BenGu0530/pengu/pengu_mujoco/docs/grid5/figs/leg_extension_vs_crank.png

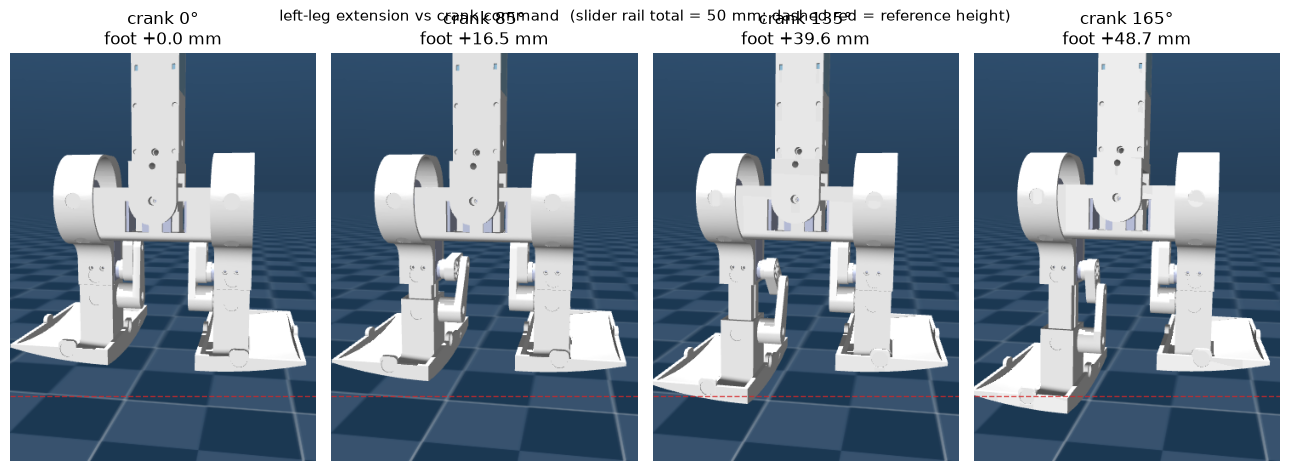
pengu_mujoco/docs/grid5/figs/leg_extension_vs_crank.png
