BenGu0530/pengu/pengu_mujoco/rl_grid4/overnight/retro_c/report.txt

=== retro_c ===
cand              vtail  vswg  fall  eplen   roll  rollμ  |μ|/R  rate   hipc   asym  sing  ePass  eNfwd
-------------------------------------------------------------------------------------------------------
no_back           0.103 0.097  0.56    349   34.3  -30.4   0.89    48   0.26  0.138  0.56   0.90  0.321   HELD-LEAN,unstable
no_fall           0.220 0.018  1.00     70   67.3   19.1   0.28    15  -0.84 -0.138  0.89   0.00  0.005   STATIC-TORSO,FAKE-TORSO

reward budget at the last diag row (per step):
cand                 track  progress      back    energy     swing     scrub    smooth        hf      fall  pos_sum     net
no_back              0.223     0.240     0.000    -0.008     0.114    -0.165    -0.011    -0.163    -0.040    0.578   0.191
no_fall              0.390     0.252    -0.051    -0.003     0.103    -0.161    -0.006    -0.072     0.000    0.745   0.453

HELD-LEAN     |roll_mean|/roll_RMS > 0.7 -- torso parked to one side, not swinging.
              This is the failure that reads as a success in the summary numbers.
STATIC-TORSO  high roll RMS but roll RATE < 30 deg/s -- leaning, barely moving.
FAKE-TORSO    high roll RMS in eval but net_fwd < 0.03 -- the exact false positive
              Ben flagged: reads as strong torso use, goes nowhere.
ASYM          |stride_asym| > 0.25 -- one leg taking much longer strides, i.e.
              curving or compensating for a held lean.
unstable      vswing > 0.05 over the last 1M steps; the vtail is a draw, not a value.
Frames: overnight/<gen>/frames/<cand>_strip.png  (t = 3, 6, 9 s stacked)
