BenGu0530/pengu/pengu_mujoco/docs/sim_reference_c6_mu01_mu05.md

# Simulation reference — pengu c6, mu = 0.1 and mu = 0.5

MuJoCo, config **c6** (torso follow gain kappa = 2, COM ratio 1.31, mass 2.2724 kg).
Generated by `pengu_mujoco/hardware/sim_stepwise.py` and `grid5/walk_prediction.py`.

## Gaits

| | freq (Hz) | hip_phi (deg) | leg_amp (deg) | hip_amp (deg) | hip_off (deg) |
|---|---|---|---|---|---|
| mu = 0.1 champion | 1.67 | 340 | 95 | 24 | 20 |
| mu = 0.5 champion | 1.92 | 240 | 115 | 20 | 10 |

`leg_amp` is also given at the amplitude the hardware servos actually deliver (0.865 of
command, velocity-limited near 430 deg/s), so 95 -> 82 and 115 -> 99.

## Velocity — per-footfall method

Body position sampled at every footfall, consecutive samples differenced. Turning counts;
within-stride oscillation cancels because every touchdown is the same gait phase.
Footfalls detected from foot-body height. `v_pooled` = total distance / total time;
`v_mean` = mean of per-step velocities; `v_net` = ||end - start|| / time for comparison.

| config | steps | v_pooled | v_mean | v_median | v_sd | v_net | step len (m) | step period (s) | distance (m) | time (s) |
|---|---|---|---|---|---|---|---|---|---|---|
| mu=0.1, leg 95 | 78 | **0.512** | 0.496 | 0.496 | 0.043 | 0.509 | 0.1419 | 0.264 | 7.98 | 15.6 |
| mu=0.1, leg 82 | 103 | **0.378** | 0.355 | 0.367 | 0.038 | 0.374 | 0.0974 | 0.264 | 5.89 | 15.6 |
| mu=0.5, leg 115 | 61 | **0.158** | 0.156 | 0.155 | 0.046 | 0.141 | 0.0395 | 0.264 | 2.51 | 15.9 |
| mu=0.5, leg 99 | 62 | **0.157** | 0.152 | 0.130 | 0.083 | 0.133 | 0.0352 | 0.258 | 2.49 | 15.9 |

All velocities in m/s. Window: 16 s, starting 6 s after the staged start settles.

## Attitude and actuator load

A = hip-axis (lower body) roll, T = torso roll, both as tilt about the torso hinge axis;
J = torso joint angle, T = A + J. The controller targets T = kappa * A, so T/A is its
objective. Torques are p95 over the window; stall is 4.1 N.m.

| | A rms (deg) | T rms (deg) | T/A | J/A | J amp (deg) | torso cmd amp (deg) |
|---|---|---|---|---|---|---|
| mu=0.1, leg 95 | 11.40 | 23.30 | 2.02 | 1.06 | 38.1 | 44.2 |
| mu=0.5, leg 115 | 1.60 | 3.30 | 2.06 | — | 7.1 | 9.6 |

| | torso p95 | hip p95 | crank p95 | torso >=90% stall |
|---|---|---|---|---|
| mu=0.1, leg 95 | 4.10 | 2.40 | 1.11 | 13.2% |
| mu=0.5, leg 115 | 1.19 | 1.56 | 1.79 | 0% |

Torque in N.m. The mu=0.1 champion holds the torso at the stall limit for 13% of the
window; the mu=0.5 gait never approaches it.

## Friction sweep — mu = 0.1 champion gait, mu varied

| mu | 0.08 | 0.10 | 0.11 | 0.12 | 0.135 | 0.15 | 0.16 | 0.175 | 0.20 |
|---|---|---|---|---|---|---|---|---|---|
| step len, leg 95 | 0.124 | 0.142 | 0.126 | 0.123 | 0.127 | 0.110 | 0.081 | 0.097 | **0.021** |
| v_pooled, leg 95 | 0.462 | 0.512 | 0.479 | 0.475 | 0.479 | 0.405 | 0.353 | 0.375 | **0.078** |
| step len, leg 82 | 0.099 | 0.097 | 0.098 | 0.096 | 0.097 | 0.094 | 0.095 | 0.089 | **0.016** |
| v_pooled, leg 82 | 0.415 | 0.378 | 0.372 | 0.357 | 0.345 | 0.351 | 0.351 | 0.327 | **0.060** |

Step length is flat from mu = 0.08 to 0.175 and collapses at 0.20.

## Contact and actuator model as configured

```
option        timestep 0.001   integrator implicitfast
              friction cone PYRAMIDAL (default)   impratio 1 (default)
floor         type plane   condim 3 (default)   geom_priority raised above the feet
              friction[0] set per surface; solref/solimp at defaults
foot geoms    friction 0.9 0.005 0.0001
joints        frictionloss 0.1   armature 0.005
actuators     position servo, kp 50, dampratio 1, forcerange +-4.1 N.m
              torso ctrlrange +-0.7854 rad;  NO velocity limit on any actuator
torso PID     kappa 2, kp 2.0, ki 0.1, kd 0, clamp +-45 deg, stepped at 1 kHz
```

Only `friction[0]` (sliding) is changed per surface. **Torsional friction stays at 0.005
and rolling at 0.0001 for every mu**, i.e. the ice and the lab floor are given identical
resistance to a foot pivoting.
