BenGu0530/pengu/pengu_mujoco/docs/grid4_fleet_memo.md

# GRID-4 fleet memo — who runs what

> **STAGED-K AMENDMENT (Ben, 2026-08-16).** The map is now swept at **K=1**
> (`DR_K=1`: one jittered trial per (cell,μ) = trial r=0 of the seeded sequence).
> Hot regions get topped up to K=5 afterwards with `physics/topup_k.py`, which runs
> r=1..4 and merges — validated bit-identical to a native K=5 sweep on the smoke grid.
> Everything else (grid, μ levels, jitters, pass rule, schema, filenames) unchanged.
> **Switch procedure on B, C and D** (Mac already switched 2026-08-16; D launched c4
> at K=5 before this amendment, so it switches too):
> ```bash
> cd ~/pengu/pengu_mujoco && git pull              # D: cd $HOME/Documents/ben_gu/ben_pengu/pengu/pengu_mujoco
> pkill -f 'grid4_sweep[.]py'                      # D: use the argv-exact kill from its memo instead
> CSV=results/gait_sweep/sweep_grid4_cN_freq_hip_phi_leg_amp_hip_amp_hip_off_mu.csv
> mv "$CSV" "$CSV.k5partial"                       # archive; NEVER mix K values in one CSV
> head -1 "$CSV.k5partial"                         # sanity: header line present
> # WSL (B/C): re-arm the anchor if the distro restarted. Then relaunch:
> DR_K=1 GRID3_PY=$HOME/pengu/pengu_mujoco/.sweep_venv/bin/python bash physics/run_sweep.sh cN
> # D (shared box): DR_K=1 GRID3_PY=$REPO/.sweep_venv/bin/python nice -n 19 bash physics/run_sweep.sh c4
> tail -2 results/gait_sweep/cN_run.log            # startup line must say K=1
> ```
> K=1 ETA: Mac ~3.4 d, B ~12 d, C ~3.8 d, D ~3 d per config.

Full spec: `docs/grid4_guide.md`. Protocol is FROZEN (commit `a22f80b`): base = hardened
`models/pengu1_31` (2.2724 kg), COM rungs {1.05, 1.20, 1.31} built in-memory at load,
μ axis {0.1, 0.3, 0.5, 0.7} ±5% rel., K=5, pose jitter, no mass jitter,
pass = survive ∧ heading>0.5 ∧ net_fwd>0.05 (slip recorded, not gated).
Do NOT change any parameter mid-fleet — one changed value = a different sweep.

## Assignment (one machine = one config = one CSV; no cross-machine merging)

| machine | now | after that |
|---|---|---|
| **Mac** (Ben's) | c1 handed off at 1,524,017 rows (2026-08-19) | idle |
| **B** (Ryzen/WSL2, `grid4_machineB_memo.md`) | **c2** — STOP after snapshot push (`grid4_c2_takeover_memo.md`) | done |
| **C** (XPS/WSL2, `grid4_xps_memo.md`) | **c3** — ✅ COMPLETE 2026-08-19 | idle / backup analysis box |
| **D** (Linux, `grid4_machineD_memo.md`) | **c1** takeover from Mac snapshot: `SWEEP_NICE=19 bash physics/resume_config.sh c1` | topup |
| **E** (friend's 32-core desktop) | **c5** ✅ | idle / topup |
| **F** (`rml3` Linux desktop, repo at `~/Documents/ben/pengu`) | **c6** ✅, analysis ✅ → **continues c2**: `bash physics/resume_c2.sh` (one-shot, self-contained) | rerun analysis when c1/c2 land |

With E/F online every config has a dedicated machine. `run_sweep.sh` now defaults GRID-4
jobs to `DR_K=1` (staged-K), so the plain one-liner is correct on a fresh clone.

When a machine frees up and c2 is still far from done, it joins c2 with a DISJOINT
shard split (e.g. B keeps `N_SHARDS=11 SHARD_ID 0..10` as-is; helper runs
`N_SHARDS=33 SHARD_ID 11..32`-style non-overlapping params into its own copy, then
concat + dedupe on the 6 axis cols). Coordinate in this file before starting.

Each config = 1,818,000 rows (+1 header). Measured rates: Mac ~4.3k rows/h,
B ~1.24k, C ~3.96k, D ~5.0k — ETA ~17/60/19/15 days respectively; resume is automatic,
restarts are safe.

## New machine setup (Linux / Mac; Windows → use WSL2; Linux VM fine)

```bash
git clone https://github.com/robomechanics/pengu.git && cd pengu/pengu_mujoco
git checkout friction-experiments
bash physics/run_sweep.sh c2          # machine C: c3   (2nd arg = shard count, default cores-2)
```

No mujoco python found → the launcher builds `.sweep_venv` and pip-installs
mujoco/numpy/cma automatically.

- Windows: install WSL2 (`wsl --install`), work inside `~/` (NOT `/mnt/c` — slow I/O),
  set Windows power to never sleep. **Native Windows does NOT work** (mujoco 3.8.x DLL
  fails to load — measured on machine C; WSL2 is mandatory).
- **WSL2 keepalive is REQUIRED**: with no terminal attached the distro shuts down within
  ~45 s and kills every shard (measured on machine B). Arm an anchor from Windows before
  walking away, and re-arm after every reboot/logoff:
  ```
  powershell -c "Start-Process wsl.exe -ArgumentList '-d','Ubuntu','-e','sleep','infinity' -WindowStyle Hidden"
  ```
- VM: give it all cores, local virtual disk (no shared folders), host must not sleep.
- Mac: `caffeinate -dimsu &` to prevent sleep. Linux: disable suspend.

## Pre-flight (2 min, before leaving a machine unattended)

1. `git rev-parse --short HEAD` matches the other machines.
2. `CONFIG=cN python physics/grid4_sweep.py count` prints
   `cells=454500 mus=[0.1, 0.3, 0.5, 0.7] rows=1818000 K=5` (and the right config/kappa/com).
   (numpy ≥2.3 prints `np.float64(0.1)` — cosmetic, values identical.)
3. After launch: `wc -l` on the CSV grows; startup line in
   `results/gait_sweep/cN_run.log` shows `com=<target> ... mass=2.2724kg`.
   To verify COM/mass without waiting for the (buffered) log, run a zero-row probe
   — **AFTER the launcher, never before it** (see step 4):
   ```bash
   CONFIG=cN N_SHARDS=999999 SHARD_ID=999998 .sweep_venv/bin/python -u physics/grid4_sweep.py
   ```
   Expected slides: 1.05→−86.05 mm, 1.20→−31.37 mm, 1.31→+8.73 mm, always `mass=2.2724kg`.
4. **Header check — do this on every machine, and before every relaunch** (machine-D
   finding, 2026-08-16):
   ```bash
   CSV=results/gait_sweep/sweep_grid4_cN_freq_hip_phi_leg_amp_hip_amp_hip_off_mu.csv
   head -1 "$CSV"          # MUST be: freq,hip_phi,leg_amp,hip_amp,hip_off,mu,...
   ```
   If line 1 is a data row, the CSV has **no header** and resume is dead: `_load_done`
   reads via `csv.DictReader`, treats row 1 as the field names, and recovers 0 rows — so
   every restart re-runs from scratch and appends duplicates. Cause: the zero-row probe
   opens the CSV with `"a"` and creates a 0-byte file, after which `initcsv`'s
   `if not os.path.exists(...)` guard skips the header. The launcher also tells you:
   `launched cN: … resuming from -1 done rows` means the file exists but is empty/headerless.
   Repair (**only while no shard is running** — shards hold the fd in append mode, so
   swapping the inode under them loses rows):
   ```bash
   # stop shards first, then:
   printf 'freq,hip_phi,leg_amp,hip_amp,hip_off,mu,pass_rate,surv_rate,net_fwd_mean,net_fwd_min,slip_mean,head_mean\r\n' > "$CSV.new"
   cat "$CSV" >> "$CSV.new" && mv "$CSV.new" "$CSV"     # CRLF: DictWriter's terminator
   ```
   Then relaunch and confirm the log says `resuming from <N> done rows` with N = data rows.
   Existing data rows are unaffected — this only restores resume.

Gotcha: pass `GRID3_PY` as an ABSOLUTE path (e.g. `$HOME/...`), not `$PWD/...` — it
expands before the script's `cd` (machine-C finding).

## Watching

```bash
wc -l results/gait_sweep/sweep_grid4_cN_freq_hip_phi_leg_amp_hip_amp_hip_off_mu.csv
tail -f results/gait_sweep/cN_run.log
```

## Ship-back when a config completes (1,818,000 rows)

```bash
CSV=results/gait_sweep/sweep_grid4_cN_freq_hip_phi_leg_amp_hip_amp_hip_off_mu.csv
awk 'NF' "$CSV" > t && mv t "$CSV"                     # strip stray blank lines
# integrity: rows=1,818,001 incl header; all NF==12; unique 6-tuples = 1,818,000
gzip -kf "$CSV" && git add -f "$CSV.gz"
git commit -m "GRID-4 cN complete" && git push
```
Then start the machine's batch-2 config (`run_sweep.sh c4/c5/c6`).
No AI attribution in commit messages. Branch: `friction-experiments`.

## Per-machine routine (compiled from the machine memos)

**B (WSL2, c2)** — details `grid4_machineB_memo.md`:
1. After every Windows reboot/logoff: re-arm the WSL anchor (command above), THEN
   relaunch: `GRID3_PY=$HOME/pengu/pengu_mujoco/.sweep_venv/bin/python bash physics/run_sweep.sh c2`.
2. Check-in: `pgrep -fc grid4_sweep.py` = 11; `wc -l` on the c2 CSV grows.
3. Ship-back at 1,818,000 rows per the block below.

**C (WSL2, c3)** — details `grid4_xps_memo.md`:
1. Same anchor + relaunch rule as B (`... run_sweep.sh c3`; expect 14 shards).
2. Check-in additionally watches for the shard-death incident: if `pgrep -fc` < 14,
   relaunch (safe), and note it in the memo — twice means it needs diagnosis.
3. Keep on AC; Modern-Standby power settings already applied (see memo).
4. After c3 ships: start c6.

**D (Linux, c4)** — details `grid4_machineD_memo.md`: no WSL anchor needed; disable
suspend once; daily `pgrep`/`wc -l`; after c4 ships, help c2 per the split above.
Two D-specific rules: the clone is at `~/Documents/ben_gu/ben_pengu/pengu/pengu_mujoco`,
not `~/pengu`; and the box is SHARED with Isaac Lab GPU training, so always launch under
`nice -n 19` (see the memo) — 14 shards at nice 0 starve the trainer's CPU-side stepping.

**Mac (c1)** — Claude-managed on Ben's machine (caffeinate + completion monitor armed);
after c1 ships: c5.

## Open items (Ben)

- pitch (torso forward-lean) axis: definition + full-cross vs staged — decides whether
  more configs are queued after batch 2. Does not block batches 1–2.
- RL (6 policies) and the mass-effect control: deferred until the table is in.

## RL-phase fleet rules (Ben, 2026-08-22 — after the C8 near-loss)

1. runs/ layout changes must be announced in a memo BEFORE pushing; other
   machines finish + commit (git add -f) local run outputs before pulling.
2. Every training run tees stdout to a .log committed alongside diag.csv.

## ANNOUNCEMENT 2026-08-22 (Mac): REWARD default changed r2 -> r3

`grid4_rl_env.py` RW_DEFAULT now includes `hf: 0.5` (high-frequency action
penalty, see rl_e2_ice_memo knob log). Any training launched AFTER pulling
this is r3 by default and tags itself r3. Consequences for in-flight work:

- overnight gen* arms: gen01/gen02 ran under r2. Post-pull generations will
  be r3 — do NOT pool them with r2 generations; the tag separates them.
- To launch an exact-r2 run under new code: `--rw hf=0.0` (retags with rw
  override, keeping pools separate).
- Eval/render/ckpt tools are unaffected (reward not used at eval).
- Mac is running the r3 2x2 rerun at rl_grid4/runs/e2x2hf/ (4 cells x 3M,
  ~5 h from 10:48 EDT); please avoid launching heavy jobs on Mac until done.

## Coordination note 2026-08-22 (Mac -> machine D)

Your e2_base (run_base_seeds.sh: --mode e2 --curriculum, default reward,
seeds 0/1/2) is the SAME recipe as Mac's runs/e2x2hf4b/a1p1 (REWARD r3d,
hf=0.6 hips+torso commanded residual) — seed 0 would be a byte-duplicate;
Mac's copy is trained+evaled (stand, 0/5 all mu). Seeds 1/2 are new and
useful. When pooling, treat e2x2hf4b/a1p1 as e2_base s0. Also: default
REWARD_VERSION moved r3 -> r3b -> r3c -> r3d within 2026-08-22 (see
rl_e2_ice_memo knob log + grid4_rl_env.py header); verify the version tag in
your run dirs matches r3d before pooling generations.

## ANNOUNCEMENT 2026-08-23 (Mac): EXECUTION layer sv0 -> sv1 (servo slew clamp)

grid4_rl_env now clamps applied position targets at 4.82 rad/s (XM430-W350
no-load @ 12 V; models Profile Velocity). Default ON for train/eval/render/
score/ckpt-sweep; `--no-slew` reproduces legacy sv0 exactly. New train runs
tag themselves `sv1`. Do NOT pool sv0 and sv1 runs. Designed baselines are
being re-scored under sv1 (see rl_session memo); legacy numbers stay archived
as sv0. If a generation is mid-flight when you pull this, finish it as sv0
(its processes hold the old code) and launch the next one under sv1.
