BenGu0530/pengu/Arduino/pengu/pengu.rtf

// EasyPengu.ino
#include <DynamixelShield.h>

#include <Wire.h>

#include <Adafruit_Sensor.h>

#include <Adafruit_BNO055.h>

#include <utility/imumaths.h>

#include <WiFiNINA.h>

using namespace ControlTableItem;

#define DEBUG_SERIAL Serial

// ===================== Motor IDs =====================
const uint8_t XM_LEFT_SLIDE = 4;
const uint8_t XM_RIGHT_SLIDE = 3;
const uint8_t XM_LEFT_HIP = 2;
const uint8_t XM_RIGHT_HIP = 1;
const uint8_t XM_TORSO_ROLL = 0;

const uint8_t MOTOR_IDS[] = {XM_LEFT_SLIDE, XM_RIGHT_SLIDE, XM_LEFT_HIP, XM_RIGHT_HIP, XM_TORSO_ROLL};
const int MOTOR_COUNT = 5;

DynamixelShield dxl;
Adafruit_BNO055 bno = Adafruit_BNO055(55, 0x28);

// ===================== State machine =====================
enum RobotState { STATE_IDLE, STATE_READY, STATE_WALK };
RobotState robot_state = STATE_IDLE;

// ===================== IMU globals (read by wireless.ino) =====================
float imu_yaw = 0, imu_roll = 0, imu_pitch = 0;
float imu_ax = 0, imu_ay = 0, imu_az = 0;
uint8_t cal_sys = 0, cal_gyro = 0, cal_accel = 0, cal_mag = 0;

// ===================== WiFi flag (set by wireless.ino) =====================
bool wifi_active = false;

// ===================== Motion params (also in param_storage.ino) =====================
float p_legAmp = 2.0f; // rad
float p_legFreq = 1.39f; // Hz
float p_hipAmp = 0.2f; // rad

// ===================== Homing =====================
float home_deg[MOTOR_COUNT];
unsigned long walk_start_ms = 0;

const float lean_angle_ticks = 30.0f;
const float torso_zero_deg = 154.0f;
float torso_amp_deg = 0.0f;

// Helper: index of motor ID in MOTOR_IDS[]
int idxOf(uint8_t id) {
for (int i = 0; i < MOTOR_COUNT; i++)
if (MOTOR_IDS[i] == id) return i;
return -1;
}

// ===================== Setup =====================
void setup() {
DEBUG_SERIAL.begin(115200);
while (!DEBUG_SERIAL);

// --- Dynamixel ---
dxl.begin(1000000);
dxl.setPortProtocolVersion(2.0);

DEBUG_SERIAL.println("Checking motors...");
bool all_ok = true;
for (int i = 0; i < MOTOR_COUNT; i++) {
uint8_t id = MOTOR_IDS[i];
if (!dxl.ping(id)) {
DEBUG_SERIAL.print("No response from ID: "); DEBUG_SERIAL.println(id);
all_ok = false;
} else {
DEBUG_SERIAL.print("Found ID: "); DEBUG_SERIAL.println(id);
}
}
if (!all_ok) {
DEBUG_SERIAL.println("ERROR: missing motors. Halting.");
while (1);
}

// --- Homing: read current pos, set extended position mode ---
DEBUG_SERIAL.println("Homing...");
for (int i = 0; i < MOTOR_COUNT; i++) {
uint8_t id = MOTOR_IDS[i];
home_deg[i] = dxl.getPresentPosition(id, UNIT_DEGREE);
dxl.torqueOff(id);
dxl.setOperatingMode(id, OP_EXTENDED_POSITION);
dxl.setGoalPosition(id, home_deg[i], UNIT_DEGREE);
dxl.torqueOn(id);
DEBUG_SERIAL.print("ID "); DEBUG_SERIAL.print(id);
DEBUG_SERIAL.print(" home = "); DEBUG_SERIAL.println(home_deg[i], 2);
}

// --- IMU ---
DEBUG_SERIAL.println("Initializing BNO055...");
if (!bno.begin()) {
DEBUG_SERIAL.println("ERROR: BNO055 not detected.");
while (1);
}
bno.setExtCrystalUse(true);
DEBUG_SERIAL.println("BNO055 ready.");

// --- WiFi AP ---
begin_wifi(); // defined in wireless.ino

robot_state = STATE_IDLE;
DEBUG_SERIAL.println("Setup complete. Send 'r' to go Ready, 'w' to Walk.");
}

// ===================== Loop =====================
void loop() {

// --- 1. Read IMU ---
update_imu();

// --- 2. Handle WiFi + get command ---
char cmd = 0;
if (wifi_active) {
cmd = update_wifi(); // defined in wireless.ino
}
// Also accept Serial commands for debugging
if (DEBUG_SERIAL.available()) {
cmd = (char)DEBUG_SERIAL.read();
}

// --- 3. State transitions ---
handle_command(cmd);

// --- 4. Run current state ---
switch (robot_state) {
case STATE_IDLE:
// torque is on but holding home, nothing to do
break;
case STATE_READY:
run_ready();
break;
case STATE_WALK:
run_walk();
break;
}

delay(20); // ~50 Hz loop
}

// ===================== Command handler =====================
void handle_command(char cmd) {
switch (cmd) {
case 'r': // Ready
if (robot_state != STATE_READY) {
DEBUG_SERIAL.println("-> READY");
robot_state = STATE_READY;
}
break;
case 'w': // Walk
if (robot_state == STATE_READY) {
DEBUG_SERIAL.println("-> WALK");
walk_start_ms = millis();
robot_state = STATE_WALK;
} else {
DEBUG_SERIAL.println("Go READY first before WALK.");
}
break;
case 'q': // Stop → back to Ready
if (robot_state == STATE_WALK) {
DEBUG_SERIAL.println("-> READY (stopped)");
robot_state = STATE_READY;
}
break;
}
}

// ===================== READY state =====================
// Hold a defined standing posture: hips neutral, legs pulled in
void run_ready() {
// For now: hold home position for all motors
// TODO: define actual stand angles once hardware is tested
for (int i = 0; i < MOTOR_COUNT; i++) {
dxl.setGoalPosition(MOTOR_IDS[i], home_deg[i], UNIT_DEGREE);
}
}

// ===================== WALK state =====================
void run_walk() {
float t = (millis() - walk_start_ms) / 1000.0f;

float s_leg = sinf(2.0f * PI * p_legFreq * t);
float s_hip = sinf(2.0f * PI * p_legFreq * t);

// --- Leg extension ---
float A_leg = p_legAmp * 180.0f / PI;
float magL = 0.5f * A_leg * (1.0f + s_leg);
float magR = A_leg - magL;
const int SIGN_LEFT = -1;
const int SIGN_RIGHT = +1;
float LlegGoal = home_deg[idxOf(XM_LEFT_SLIDE)] + SIGN_LEFT * magL;
float RlegGoal = home_deg[idxOf(XM_RIGHT_SLIDE)] + SIGN_RIGHT * magR;

// --- Hip pitch ---
float A_hip = p_hipAmp * 180.0f / PI;
float magHL = 0.5f * A_hip * (1.0f + s_hip);
float magHR = A_hip - magHL;
const int SIGN_BACK_LEFT = +1;
const int SIGN_BACK_RIGHT = -1;
float LhipGoal = home_deg[idxOf(XM_LEFT_HIP)] + SIGN_BACK_LEFT * magHL - lean_angle_ticks;
float RhipGoal = home_deg[idxOf(XM_RIGHT_HIP)] + SIGN_BACK_RIGHT * magHR + lean_angle_ticks;

// --- Torso ---
float torsoGoal = home_deg[idxOf(XM_TORSO_ROLL)] + torso_amp_deg * s_leg;

// Send
dxl.setGoalPosition(XM_LEFT_SLIDE, LlegGoal, UNIT_DEGREE);
dxl.setGoalPosition(XM_RIGHT_SLIDE, RlegGoal, UNIT_DEGREE);
dxl.setGoalPosition(XM_LEFT_HIP, LhipGoal, UNIT_DEGREE);
dxl.setGoalPosition(XM_RIGHT_HIP, RhipGoal, UNIT_DEGREE);
dxl.setGoalPosition(XM_TORSO_ROLL, torsoGoal, UNIT_DEGREE);
}

// ===================== IMU update =====================
void update_imu() {
imu::Vector<3> euler = bno.getVector(Adafruit_BNO055::VECTOR_EULER);
imu::Vector<3> accel = bno.getVector(Adafruit_BNO055::VECTOR_LINEARACCEL);
bno.getCalibration(&cal_sys, &cal_gyro, &cal_accel, &cal_mag);

imu_yaw = euler.x();
imu_roll = euler.y();
imu_pitch = euler.z();
imu_ax = accel.x();
imu_ay = accel.y();
imu_az = accel.z();
}
