BenGu0530/pengu/pengu_mujoco/results/grid4_report/REPORT.md

# GRID-4 report

configs included: c1 (κ=0, COM 1.05), c2 (κ=0, COM 1.2), c3 (κ=0, COM 1.31), c4 (κ=2, COM 1.05), c5 (κ=2, COM 1.2), c6 (κ=2, COM 1.31)

## Per-config, per-mu

| config | mu | pass>0 % | mean pass | nbhd>=0.8 | best net_fwd |
|---|---|---|---|---|---|
| c1 | 0.1 | 12.6 | 0.1261 | 35135 | 0.170 |
| c1 | 0.3 | 20.1 | 0.2012 | 63823 | 0.261 |
| c1 | 0.5 | 12.2 | 0.1220 | 24163 | 0.350 |
| c1 | 0.7 | 8.3 | 0.0828 | 11471 | 0.260 |
| c2 | 0.1 | 10.6 | 0.1063 | 26258 | 0.196 |
| c2 | 0.3 | 10.1 | 0.1007 | 17708 | 0.321 |
| c2 | 0.5 | 7.1 | 0.0706 | 10398 | 0.383 |
| c2 | 0.7 | 4.1 | 0.0408 | 4388 | 0.239 |
| c3 | 0.1 | 4.2 | 0.0417 | 2948 | 0.171 |
| c3 | 0.3 | 4.1 | 0.0406 | 1468 | 0.660 |
| c3 | 0.5 | 1.9 | 0.0195 | 252 | 0.274 |
| c3 | 0.7 | 1.1 | 0.0106 | 130 | 0.186 |
| c4 | 0.1 | 31.7 | 0.3169 | 97468 | 0.370 |
| c4 | 0.3 | 31.7 | 0.3173 | 101474 | 0.620 |
| c4 | 0.5 | 12.8 | 0.1275 | 22063 | 0.379 |
| c4 | 0.7 | 9.9 | 0.0992 | 14224 | 0.269 |
| c5 | 0.1 | 23.6 | 0.2360 | 60625 | 0.574 |
| c5 | 0.3 | 10.6 | 0.1055 | 18812 | 0.425 |
| c5 | 0.5 | 2.5 | 0.0247 | 883 | 0.296 |
| c5 | 0.7 | 2.0 | 0.0202 | 602 | 0.250 |
| c6 | 0.1 | 5.6 | 0.0558 | 3697 | 0.602 |
| c6 | 0.3 | 2.1 | 0.0214 | 125 | 0.345 |
| c6 | 0.5 | 0.9 | 0.0086 | 36 | 0.240 |
| c6 | 0.7 | 0.8 | 0.0079 | 47 | 0.209 |

## freq-edge pressure (share of nbhd>=0.8 cells at freq >= 1.9, mu=0.1)

| config | share |
|---|---|
| c1 | 7.9% |
| c2 | 9.2% |
| c3 | 9.0% |
| c4 | 7.1% |
| c5 | 7.8% |
| c6 | 6.3% |

## overlap

see overlap_mu01.png — Jaccard of pass>0 cell sets at mu=0.1.
