BenGu0530/pengu/pengu_mujoco/results/grid5_report/k5/champ_k5_table.md

# Champion K=5 checkup (GRID-4, working notes)

K1 = single-seed map value; K5 = topup_k.py aggregate over the 5 protocol seeds.
M1: floor pass>=0.8, rank K5 mean.  M2: rank net_fwd_min.  M4: M1 AND nbhd>=0.8.

## Champions (map T-speed #1 per config, mu)

| cfg | mu | K1 champ | K5 mean | K5 min | pass | nbhd | K5/K1 | M1 champ | M2 champ | M4 champ |
|---|---|---|---|---|---|---|---|---|---|---|
| c1 | 0.1 | 0.170 | 0.169 | 0.167 | 1.0 | 1.00 | 0.99 | f1.8/φ260 (0.169) | f1.81/φ260 (0.169) | f1.8/φ260 (0.169) |
| c1 | 0.3 | 0.261 | 0.237 | 0.213 | 1.0 | nan | 0.91 | f1.94/φ280 (0.250) | f1.94/φ280 (0.242) | f1.92/φ280 (0.247) |
| c1 | 0.5 | 0.350 | 0.319 | 0.240 | 1.0 | 0.93 | 0.91 | f2/φ0 (0.336) | f1.99/φ0 (0.314) | f1.95/φ0 (0.319) |
| c1 | 0.7 | 0.260 | 0.045 | -0.059 | 0.4 | 0.27 | 0.17 | f1.93/φ250 (0.225) | f1.93/φ250 (0.225) | — |
| c2 | 0.1 | 0.196 | no K5 | | | 0.27 | | | | |
| c2 | 0.3 | 0.321 | no K5 | | | 0.73 | | | | |
| c2 | 0.5 | 0.383 | no K5 | | | nan | | | | |
| c2 | 0.7 | 0.239 | no K5 | | | 0.13 | | | | |
| c3 | 0.1 | 0.171 | 0.098 | 0.000 | 0.6 | 0.67 | 0.57 | f1.61/φ330 (0.164) | f1.61/φ330 (0.164) | f1.9/φ280 (0.163) |
| c3 | 0.3 | 0.660 | 0.490 | 0.251 | 1.0 | 0.33 | 0.74 | f1.97/φ20 (0.490) | f1.97/φ20 (0.490) | — |
| c3 | 0.5 | 0.274 | 0.198 | 0.085 | 1.0 | 0.33 | 0.72 | f1.86/φ240 (0.229) | f1.86/φ240 (0.229) | — |
| c3 | 0.7 | 0.186 | -0.001 | -0.189 | 0.2 | 0.07 | -0.00 | — | — | — |
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
| c5 | 0.5 | 20/20 | 0 | 4 | 5 | 11 | 3 | 0.62 |
| c5 | 0.7 | 20/20 | 1 | 5 | 6 | 8 | 2 | 0.55 |
| c6 | 0.1 | 20/20 | 5 | 6 | 8 | 1 | 5 | 0.56 |
| c6 | 0.3 | 20/20 | 0 | 8 | 3 | 9 | 0 | 0.56 |
| c6 | 0.5 | 20/20 | 0 | 0 | 2 | 18 | 0 | 0.38 |
| c6 | 0.7 | 20/20 | 0 | 1 | 1 | 18 | 2 | 0.57 |
