BenGu0530/pengu/pengu_mujoco/rl_grid4/overnight/e2_base/report.txt

=== e2_base ===
cand              vtail  vswg  fall  eplen   roll  rollμ  |μ|/R  rate   hipc   asym  sing  ePass  eNfwd
-------------------------------------------------------------------------------------------------------
base_s1           0.095 0.074  0.54    350   75.5  -18.0   0.24    34   0.64  0.271  0.53   0.00  0.017   FAKE-TORSO,unstable,ASYM
base_s2           0.052 0.049  0.78    241   58.7    0.6   0.01    25   0.38 -0.087  0.66   0.00  0.001   STATIC-TORSO,FAKE-TORSO
base_s3           0.078 0.023  0.83    112   31.1  -14.1   0.45   373  -0.46  0.260  0.45   0.00  0.000   FAKE-TORSO,ASYM

reward budget at the last diag row (per step):
cand                 track  progress      back    energy     swing     scrub    smooth        hf  straight      fall  pos_sum     net
base_s1              0.252     0.169    -0.132    -0.005     0.078    -0.126    -0.010    -0.123         -    -0.046    0.499   0.057
base_s2              0.142     0.089    -0.084    -0.003     0.053    -0.113    -0.006    -0.075         -    -0.081    0.284  -0.079
base_s3              0.545     0.075    -0.025    -0.006     0.153    -0.102    -0.006    -0.112         -    -0.295    0.773   0.228

HELD-LEAN     |roll_mean|/roll_RMS > 0.7 -- torso parked to one side, not swinging.
              This is the failure that reads as a success in the summary numbers.
STATIC-TORSO  high roll RMS but roll RATE < 30 deg/s -- leaning, barely moving.
FAKE-TORSO    high roll RMS in eval but net_fwd < 0.03 -- the exact false positive
              Ben flagged: reads as strong torso use, goes nowhere.
ASYM          |stride_asym| > 0.25 -- one leg taking much longer strides, i.e.
              curving or compensating for a held lean.
unstable      vswing > 0.05 over the last 1M steps; the vtail is a draw, not a value.
Frames: overnight/<gen>/frames/<cand>_strip.png  (t = 3, 6, 9 s stacked)
