BenGu0530/pengu/pengu_mujoco/rl_grid4/overnight/retro_a/report.txt

=== retro_a ===
cand              vtail  vswg  fall  eplen   roll  rollμ  |μ|/R  rate   hipc   asym  sing  ePass  eNfwd
-------------------------------------------------------------------------------------------------------
no_progress       0.141 0.069  0.38    392   26.4  -20.9   0.79    40   0.52 -0.062  0.59   0.70  0.205   HELD-LEAN,unstable
no_swing          0.181 0.130  0.91    196   32.4  -10.4   0.32    67   0.31  0.024  0.63   1.00  0.165   unstable
no_track          0.124 0.051  0.56    357   37.3    2.2   0.06    52   0.37  0.047  0.50   0.20  0.029   FAKE-TORSO,unstable

reward budget at the last diag row (per step):
cand                 track  progress      back    energy     swing     scrub    smooth        hf      fall  pos_sum     net
no_progress          0.119     0.000    -0.129    -0.007     0.109    -0.136    -0.019         -    -0.032    0.228  -0.094
no_swing             0.180     0.305    -0.118    -0.008     0.000    -0.176    -0.018         -    -0.084    0.486   0.081
no_track             0.000     0.253    -0.198    -0.011     0.126    -0.178    -0.015         -    -0.040    0.379  -0.064

HELD-LEAN     |roll_mean|/roll_RMS > 0.7 -- torso parked to one side, not swinging.
              This is the failure that reads as a success in the summary numbers.
STATIC-TORSO  high roll RMS but roll RATE < 30 deg/s -- leaning, barely moving.
FAKE-TORSO    high roll RMS in eval but net_fwd < 0.03 -- the exact false positive
              Ben flagged: reads as strong torso use, goes nowhere.
ASYM          |stride_asym| > 0.25 -- one leg taking much longer strides, i.e.
              curving or compensating for a held lean.
unstable      vswing > 0.05 over the last 1M steps; the vtail is a draw, not a value.
Frames: overnight/<gen>/frames/<cand>_strip.png  (t = 3, 6, 9 s stacked)
