BenGu0530/pengu/pengu_mujoco/docs/grid5/figs/hip_swing_vs_amp.png

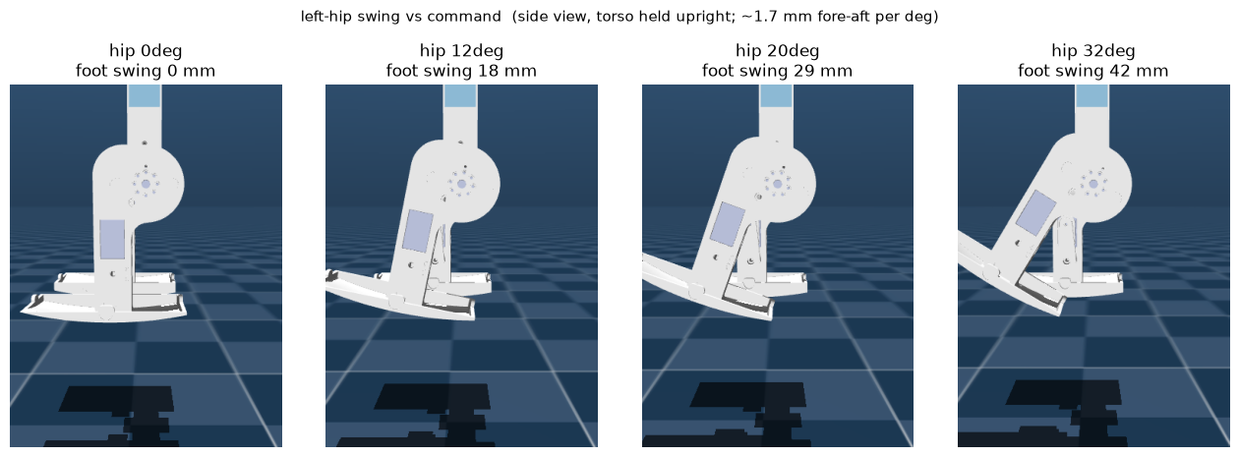
pengu_mujoco/docs/grid5/figs/hip_swing_vs_amp.png
