BenGu0530/pengu/pengu_mujoco/results/grid4_report/c1/heatmap.png

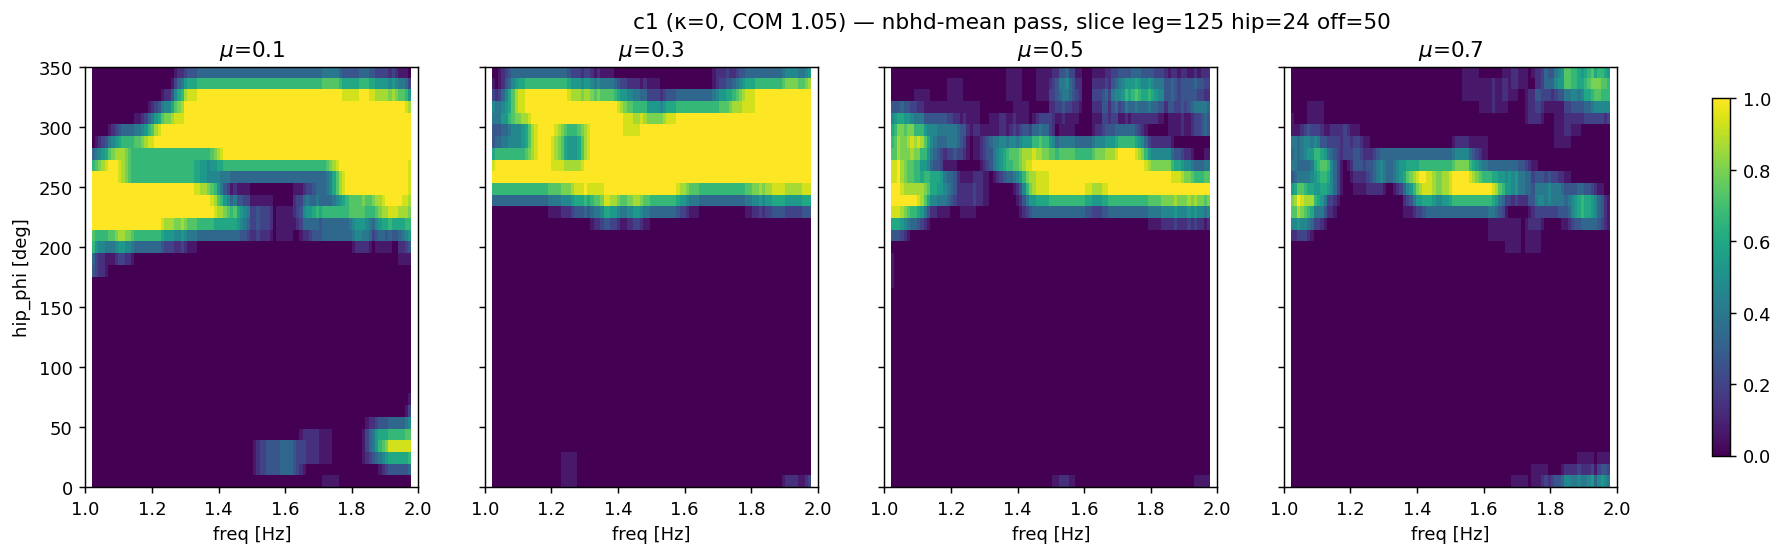
pengu_mujoco/results/grid4_report/c1/heatmap.png
