BenGu0530/pengu/pengu_mujoco/results/grid4_report/c2/heatmap.png

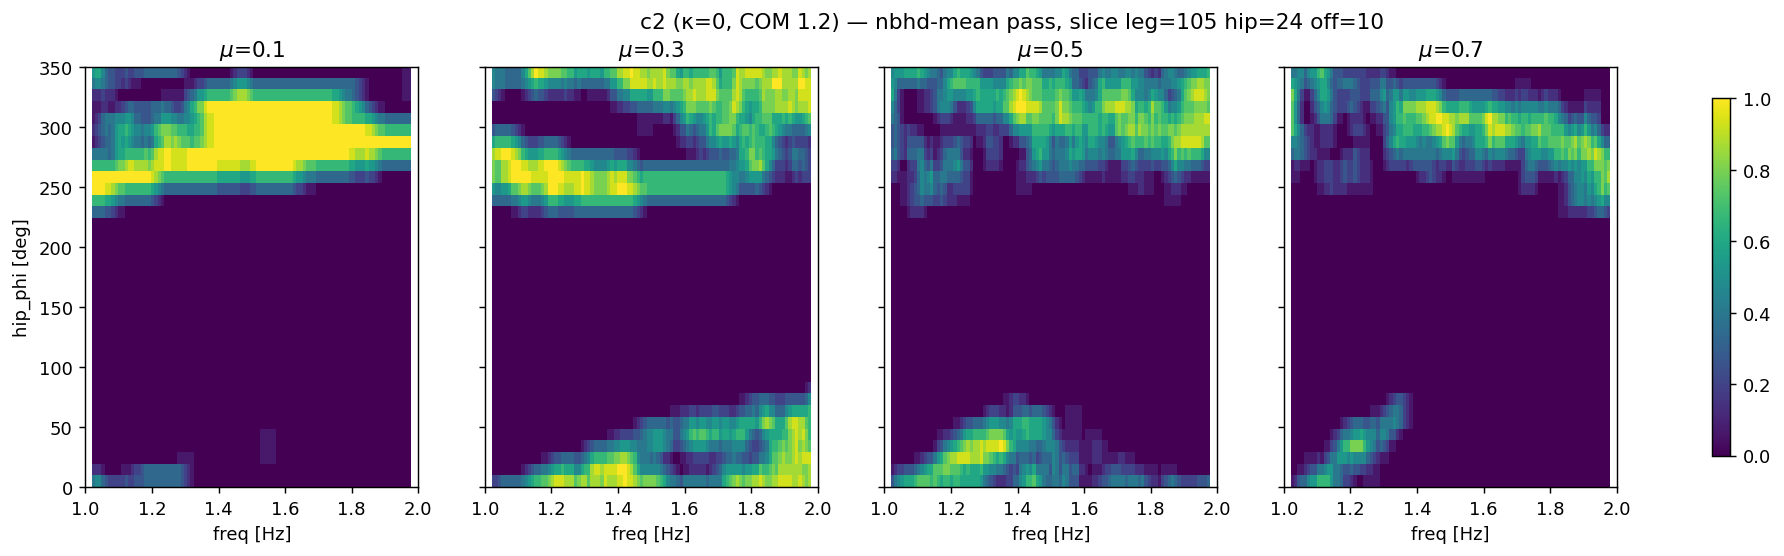
pengu_mujoco/results/grid4_report/c2/heatmap.png
