BenGu0530/pengu/pengu_mujoco/results/grid4_report/c4/heatmap.png

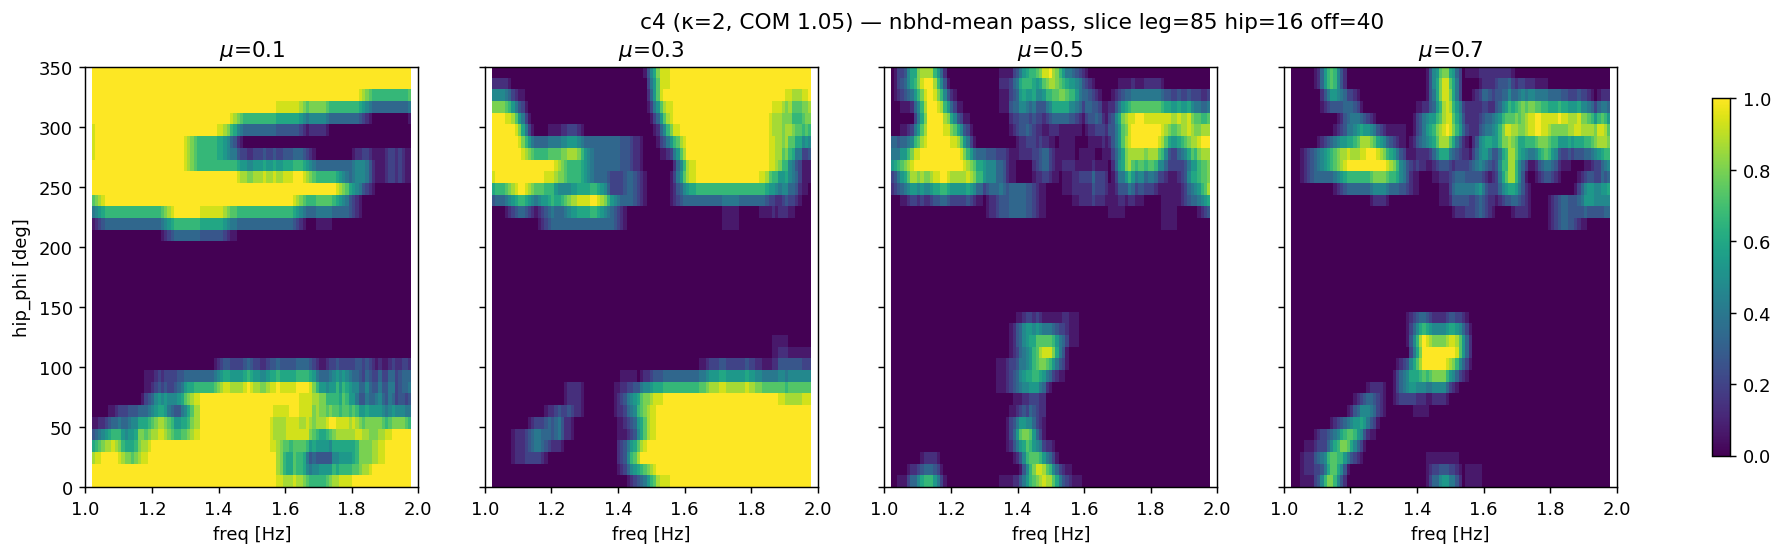
pengu_mujoco/results/grid4_report/c4/heatmap.png
