BenGu0530/pengu/pengu_mujoco/results/grid4_report/c6/com_wiper_mu01.png

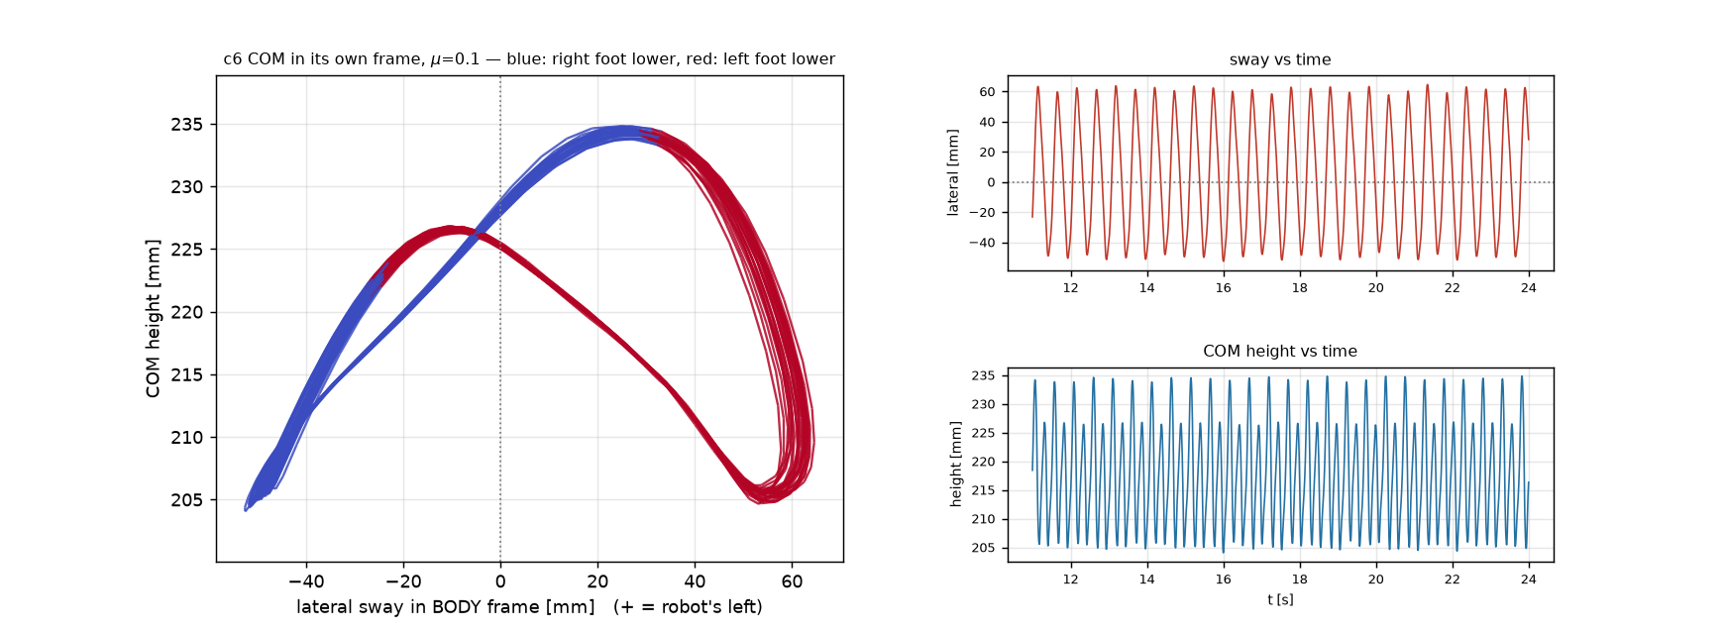
pengu_mujoco/results/grid4_report/c6/com_wiper_mu01.png
