BenGu0530/pengu/pengu_mujoco/results/grid4_report/cross/diag_matrix.png

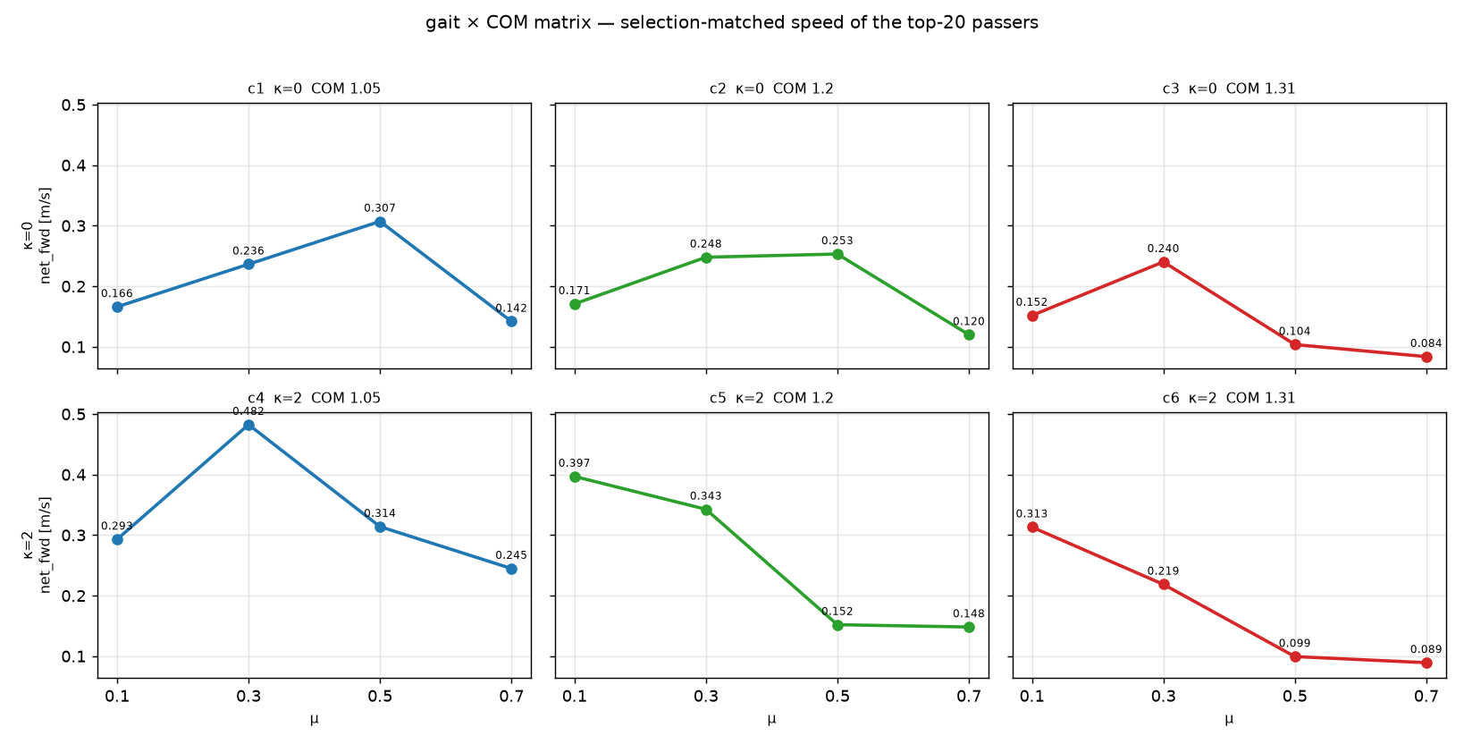
pengu_mujoco/results/grid4_report/cross/diag_matrix.png
