BenGu0530/pengu/pengu_mujoco/results/grid4_report/cross/diag_pass_vs_mu.png

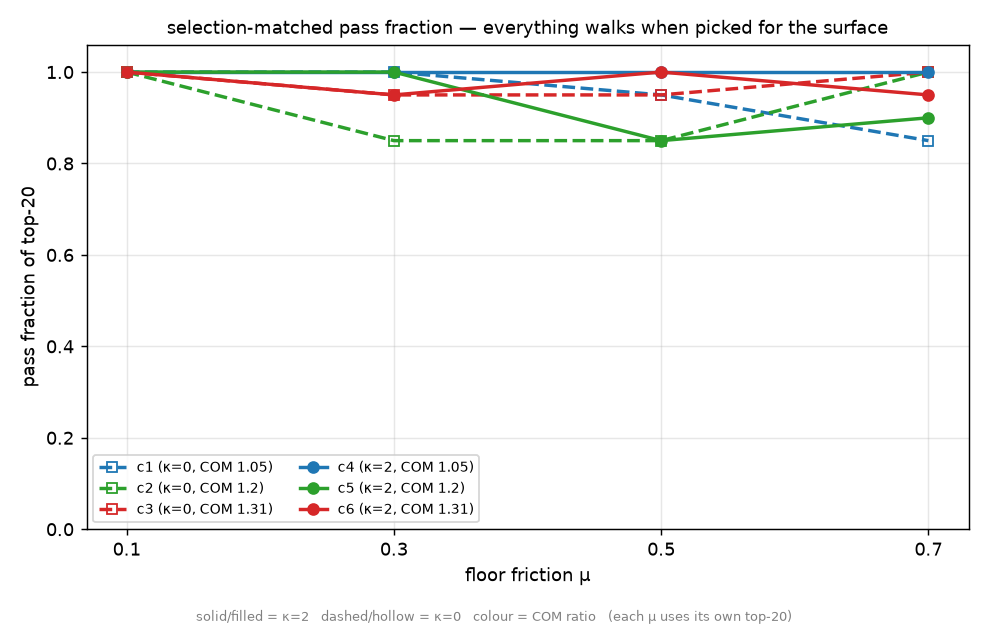
pengu_mujoco/results/grid4_report/cross/diag_pass_vs_mu.png
