BenGu0530/pengu/pengu_mujoco/results/grid4_report/cross/ds_move_mu01.png

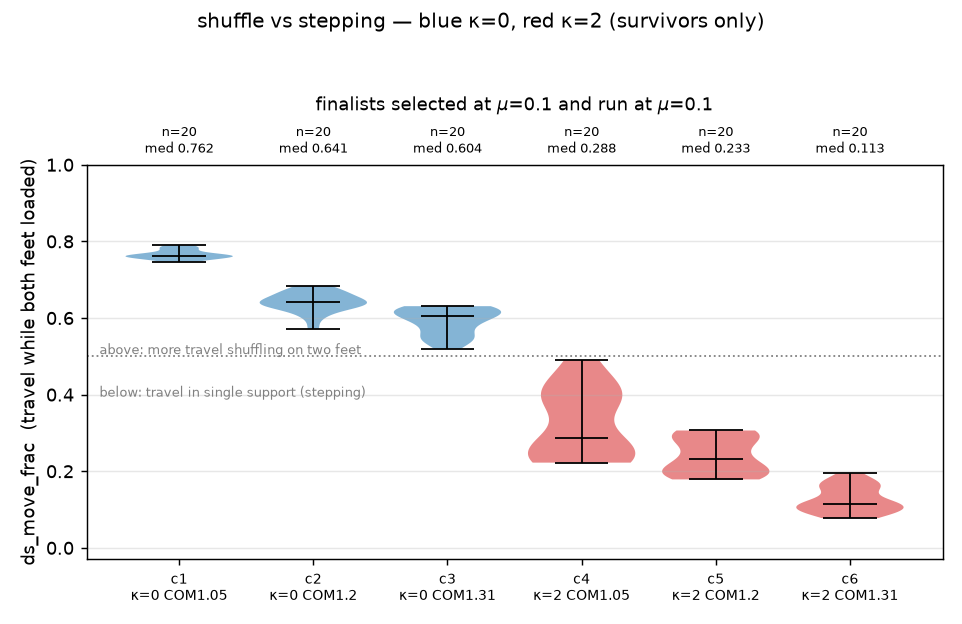
pengu_mujoco/results/grid4_report/cross/ds_move_mu01.png
