BenGu0530/pengu/pengu_mujoco/results/grid4_report/cross/overlap_mu01.png

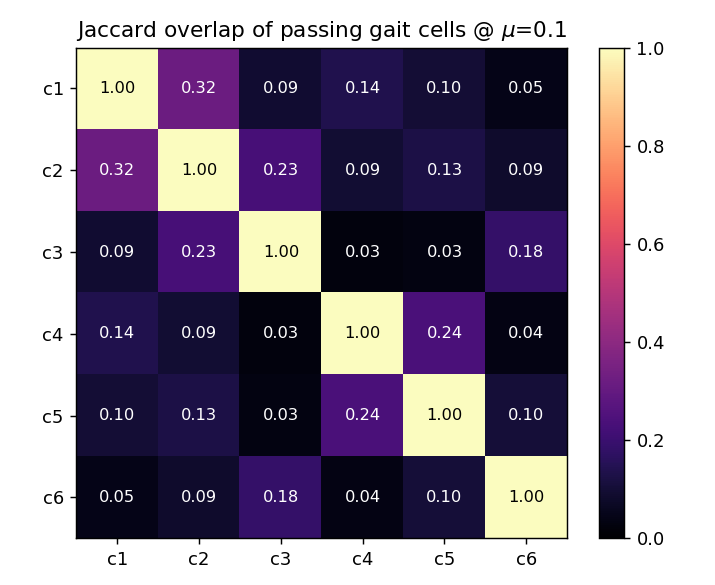
pengu_mujoco/results/grid4_report/cross/overlap_mu01.png
