BenGu0530/pengu/pengu_mujoco/results/grid4_report/cross/passfrac_vs_mu.png

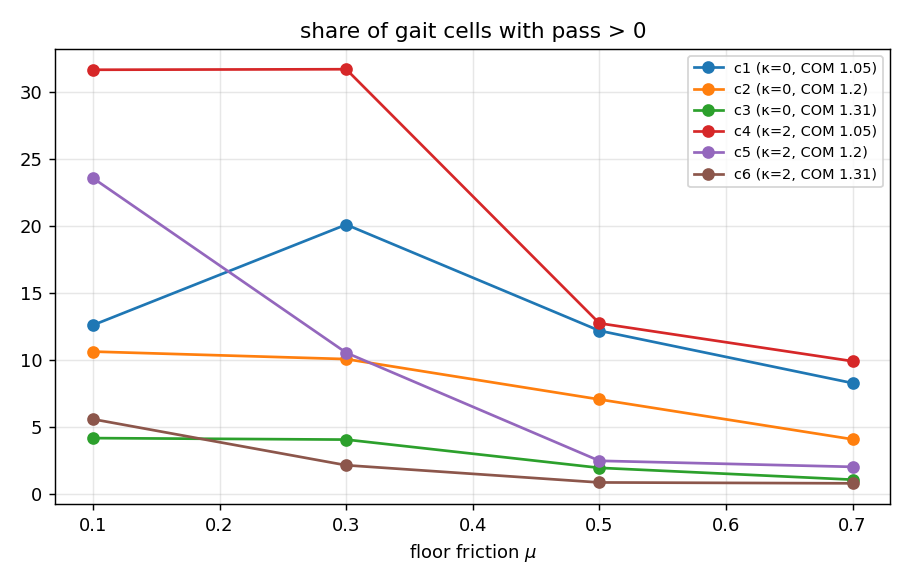
pengu_mujoco/results/grid4_report/cross/passfrac_vs_mu.png
