BenGu0530/pengu/pengu_mujoco/results/grid5_report/c6/demos/champ_g4gait_mu01_torso_roll_trace.png

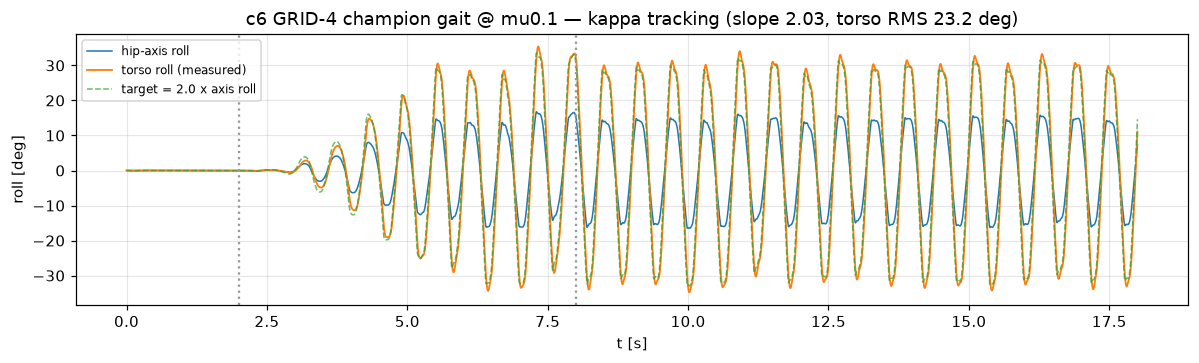
pengu_mujoco/results/grid5_report/c6/demos/champ_g4gait_mu01_torso_roll_trace.png
