BenGu0530/pengu/pengu_mujoco/results/grid5_report/k5/k5_inflation_c4.png

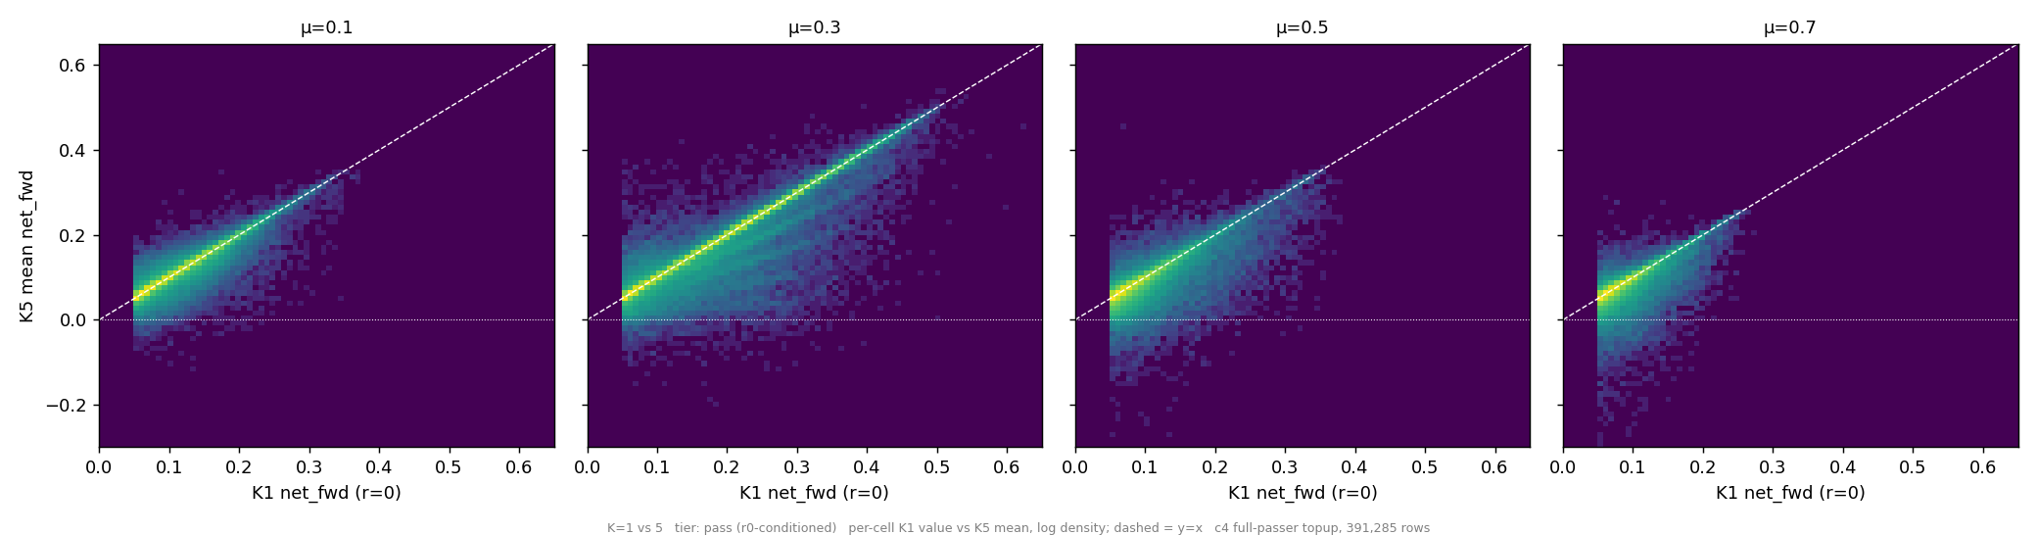
pengu_mujoco/results/grid5_report/k5/k5_inflation_c4.png
