BenGu0530/pengu/pengu_mujoco/rl_grid4/overnight/a_recipe/frames/r3f_s2_t9.png

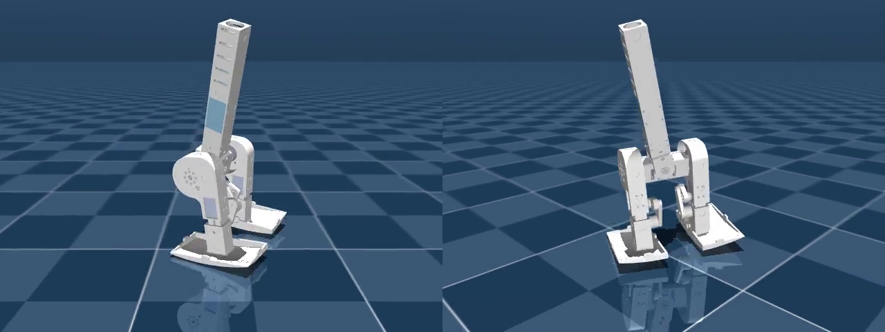
pengu_mujoco/rl_grid4/overnight/a_recipe/frames/r3f_s2_t9.png
