BenGu0530/pengu/pengu_mujoco/rl_grid4/overnight/gen02/frames/prog3_strip.png

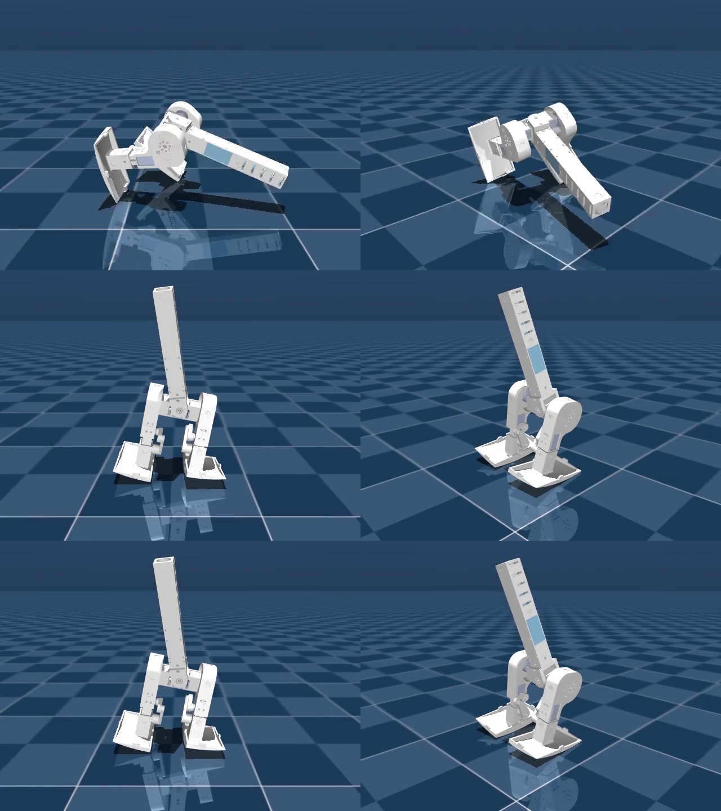
pengu_mujoco/rl_grid4/overnight/gen02/frames/prog3_strip.png
