BenGu0530/pengu/pengu_mujoco/rl_grid4/overnight/retro_a/frames/no_track_strip.png

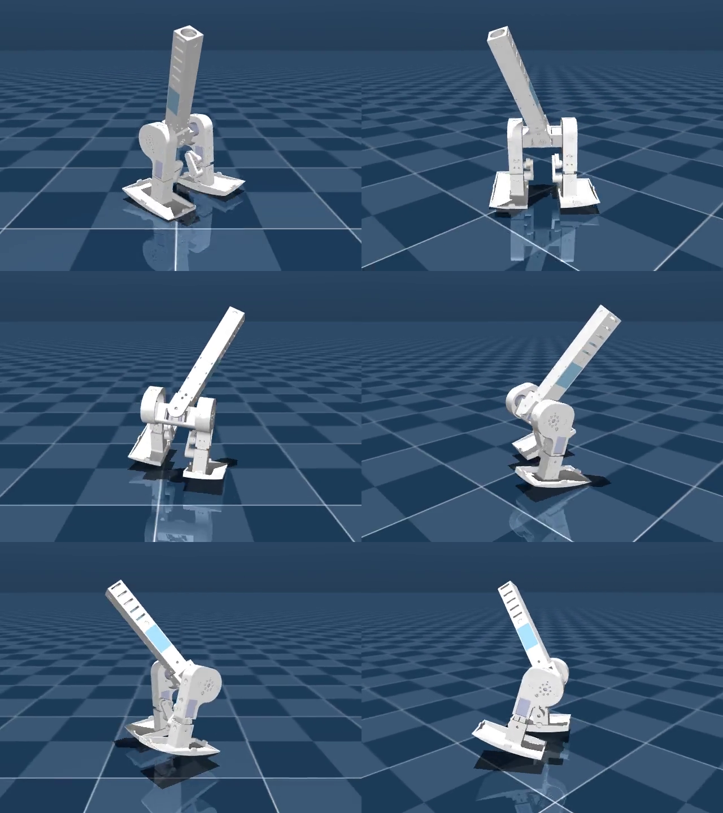
pengu_mujoco/rl_grid4/overnight/retro_a/frames/no_track_strip.png
