BenGu0530/pengu/pengu_mujoco/rl_grid4/overnight/retro_b/frames/no_scrub_strip.png

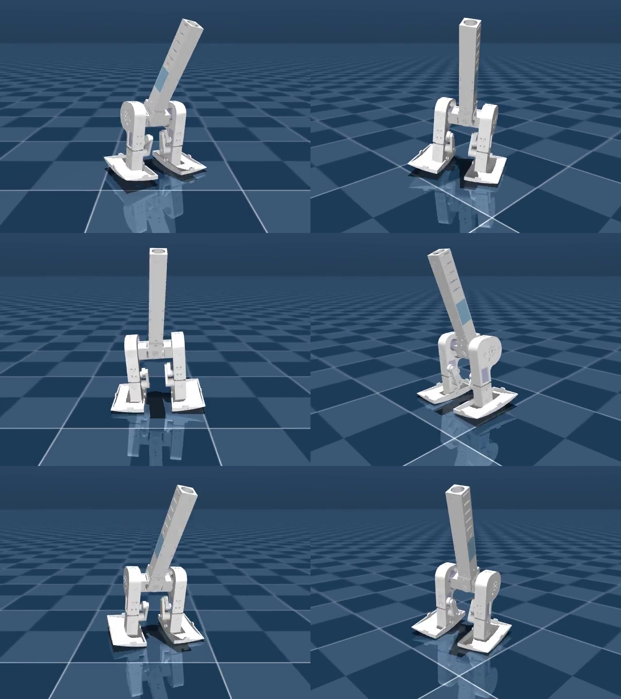
pengu_mujoco/rl_grid4/overnight/retro_b/frames/no_scrub_strip.png
