BenGu0530/pengu/pengu_mujoco/rl_grid4/overnight/retro_c/frames/no_fall_t3.png

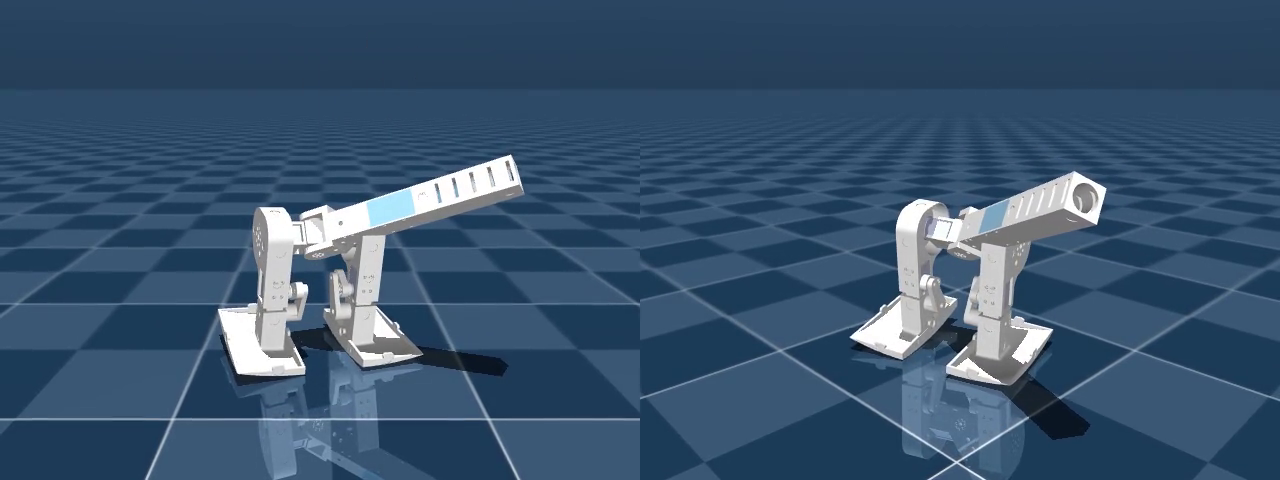
pengu_mujoco/rl_grid4/overnight/retro_c/frames/no_fall_t3.png
