BenGu0530/pengu/models/pengu1_05cad/assets/pengu2axis010.stl

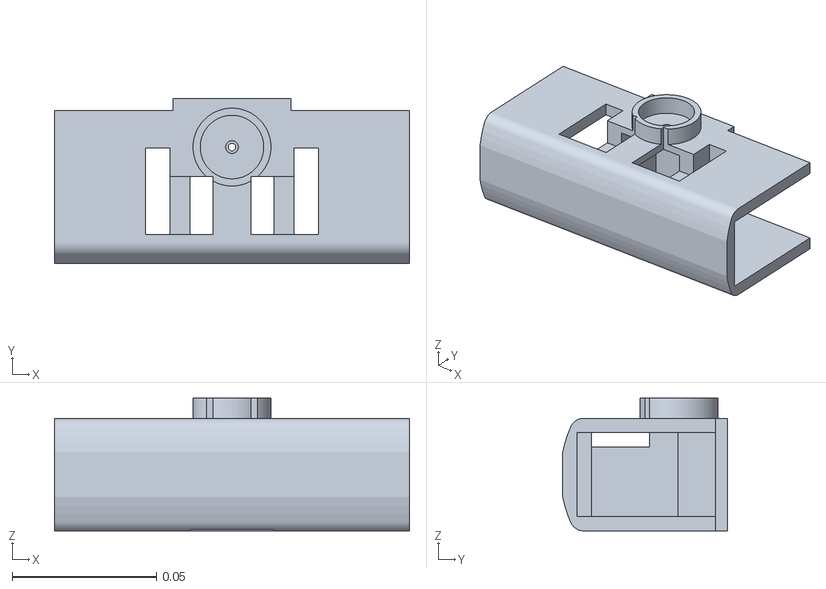
[picture p61: CAD file, 2026-09-01]
models/pengu1_05cad/assets/pengu2axis010.stl
0.123 x 0.057 x 0.046
