BenGu0530/pengu/models/pengu1_10/assets/part_1__2.stl

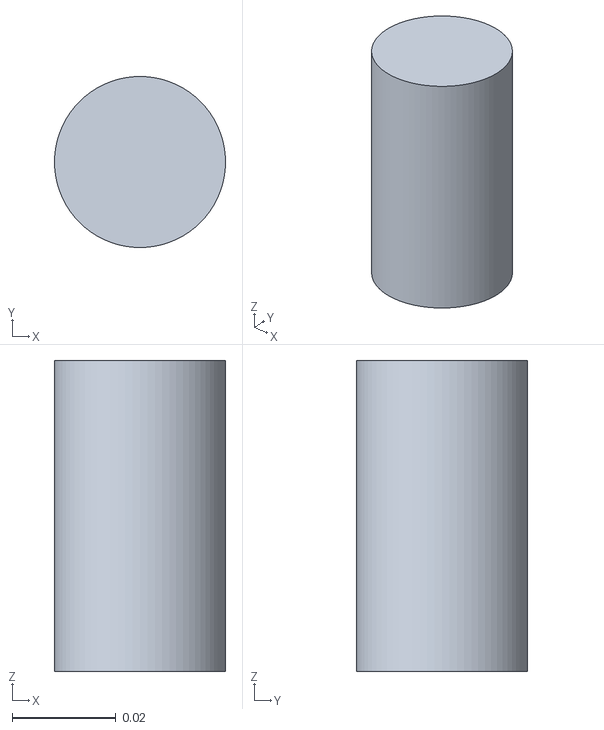
[picture p62: CAD file, 2026-08-14]
models/pengu1_10/assets/part_1__2.stl
0.033 x 0.033 x 0.06
