BenGu0530/pengu/models/pengu1_05cad/assets/10g.stl

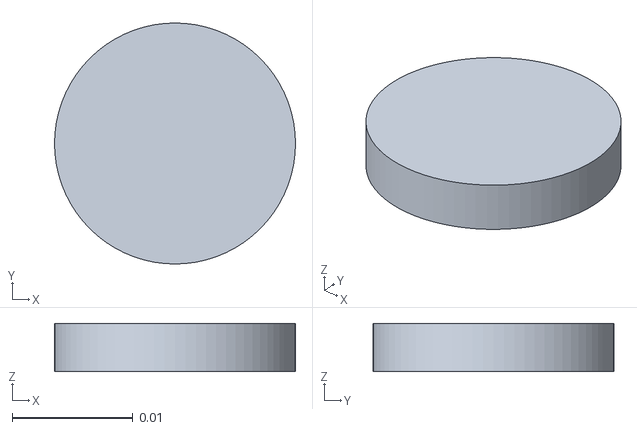
[picture p63: CAD file, 2026-09-01]
models/pengu1_05cad/assets/10g.stl
0.02 x 0.02 x 0.004
