BenGu0530/pengu/models/pengu1_05cad/assets/easymotorwithconnector.stl

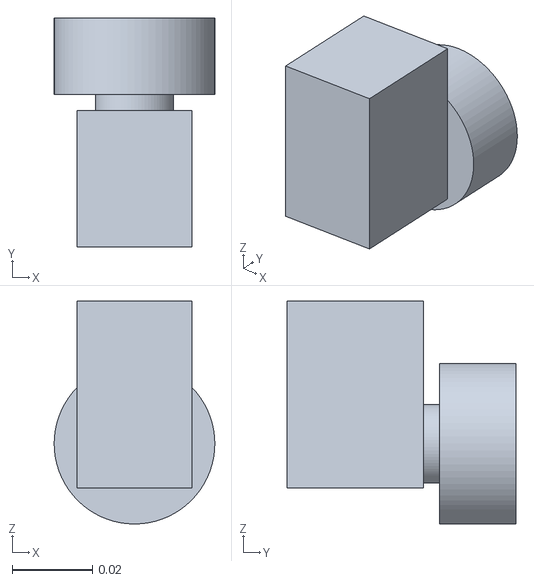
[picture p64: CAD file, 2026-09-01]
models/pengu1_05cad/assets/easymotorwithconnector.stl
0.04 x 0.057 x 0.0555
