BenGu0530/pengu/models/pengu1_05cad/assets/10g_holder__short.stl

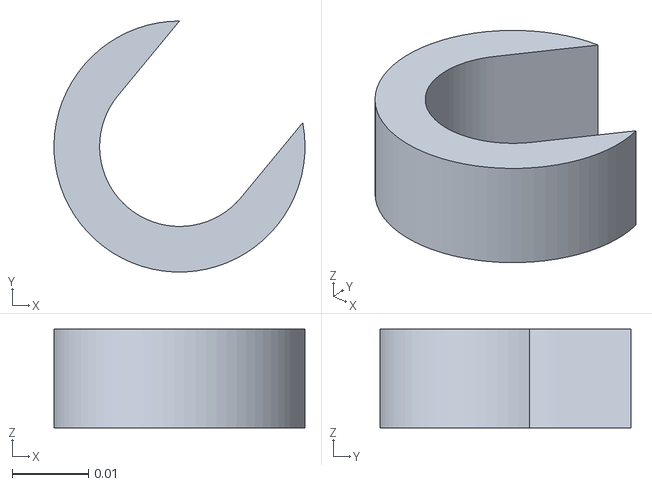
[picture p65: CAD file, 2026-09-01]
models/pengu1_05cad/assets/10g_holder__short.stl
0.033 x 0.033 x 0.013
