BenGu0530/pengu/models/pengu1_05cad/assets/torso.stl

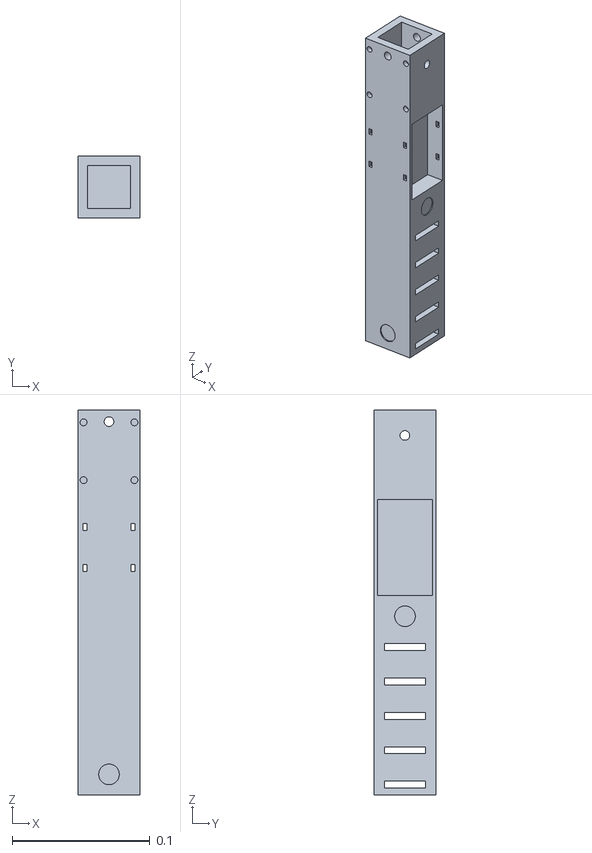
[picture p66: CAD file, 2026-09-01]
models/pengu1_05cad/assets/torso.stl
0.045 x 0.045 x 0.28
