BenGu0530/pengu/models/pengu1_10/assets/part_1.stl

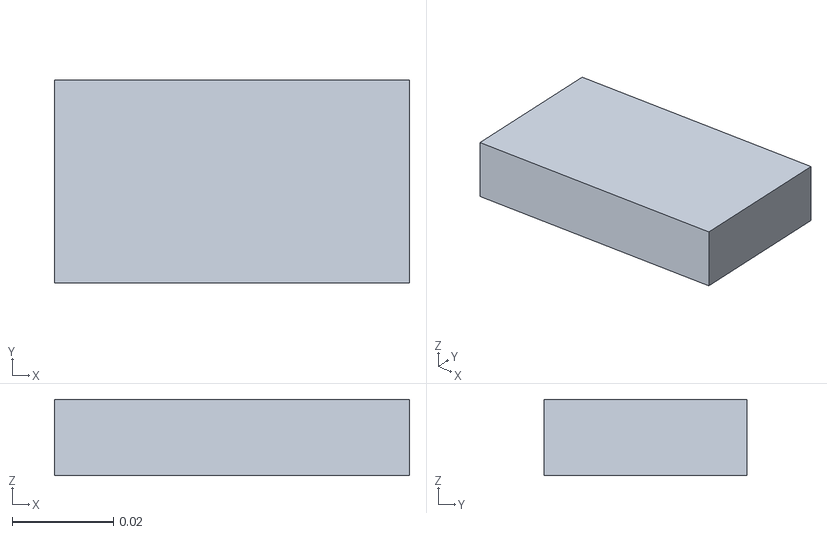
[picture p67: CAD file, 2026-04-13]
models/pengu1_10/assets/part_1.stl
0.07 x 0.04 x 0.015
