BenGu0530/pengu/models/pengu1_05cad/assets/holder_back.stl

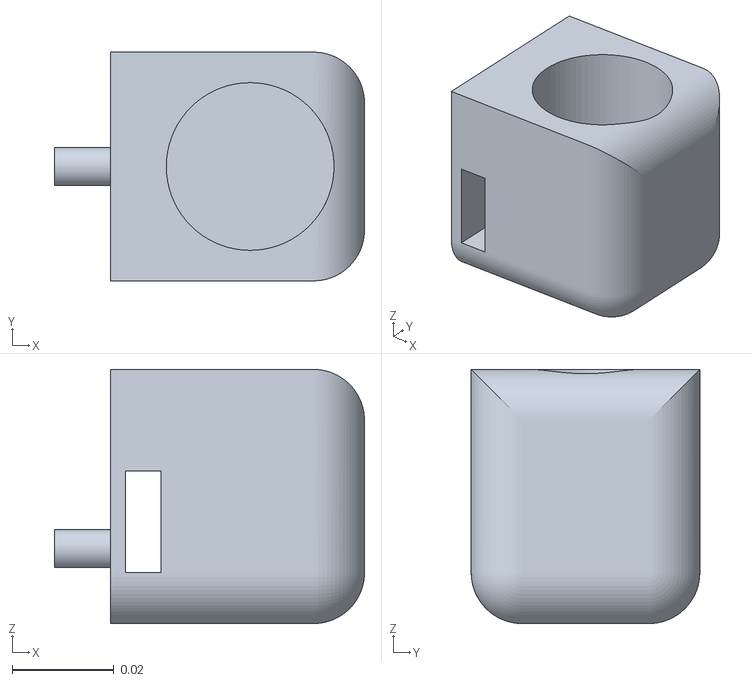
[picture p68: CAD file, 2026-09-01]
models/pengu1_05cad/assets/holder_back.stl
0.061 x 0.045 x 0.05
