BenGu0530/pengu/models/pengu1_05cad/assets/holder_front.stl

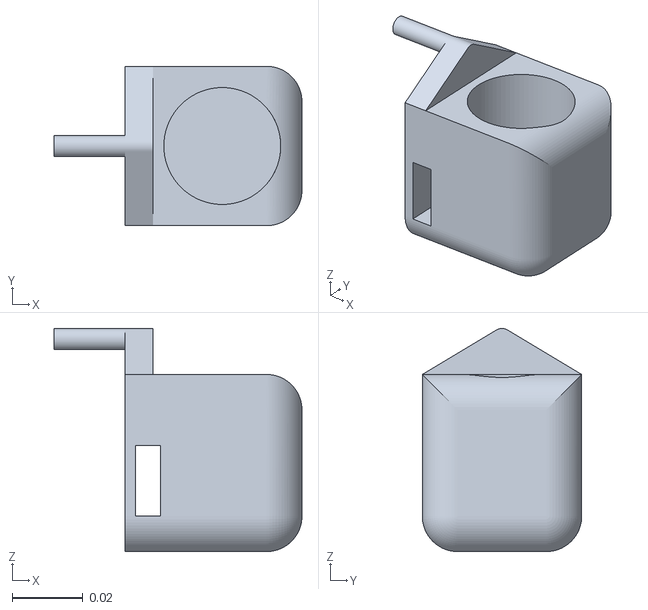
[picture p69: CAD file, 2026-09-01]
models/pengu1_05cad/assets/holder_front.stl
0.07 x 0.045 x 0.063
