BenGu0530/pengu/models/pengu1_05cad/assets/right_foot0080___fillet13.stl

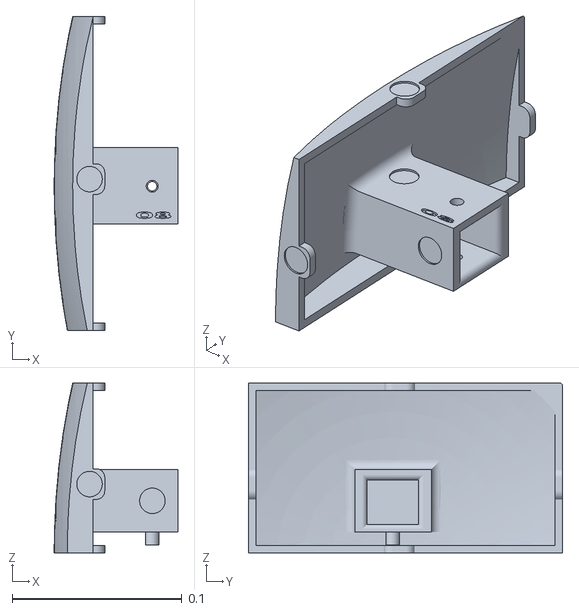
[picture p70: CAD file, 2026-09-01]
models/pengu1_05cad/assets/right_foot0080___fillet13.stl
0.0728 x 0.185 x 0.1
