BenGu0530/pengu/models/pengu1_05cad/assets/bracketbearingside.stl

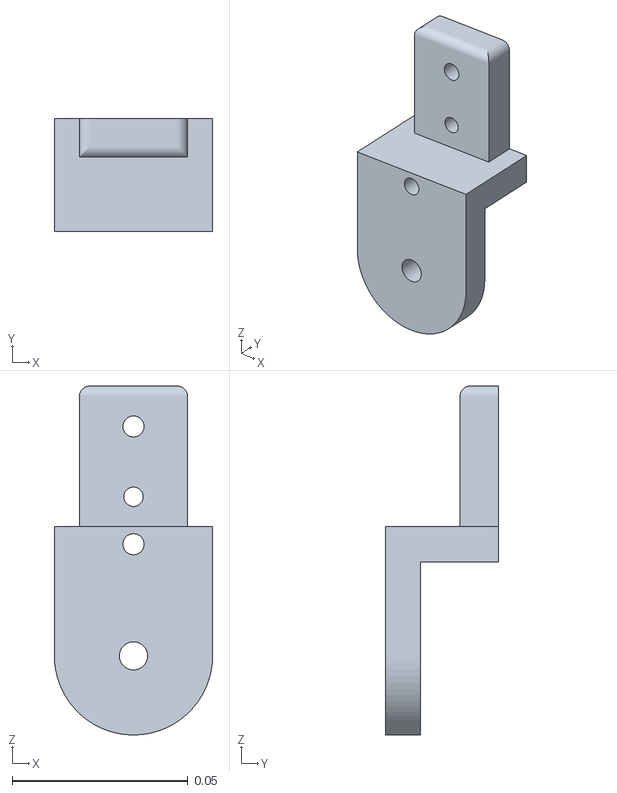
[picture p71: CAD file, 2026-09-01]
models/pengu1_05cad/assets/bracketbearingside.stl
0.045 x 0.0322 x 0.0992
