BenGu0530/pengu/models/pengu1_05cad/assets/100g.stl

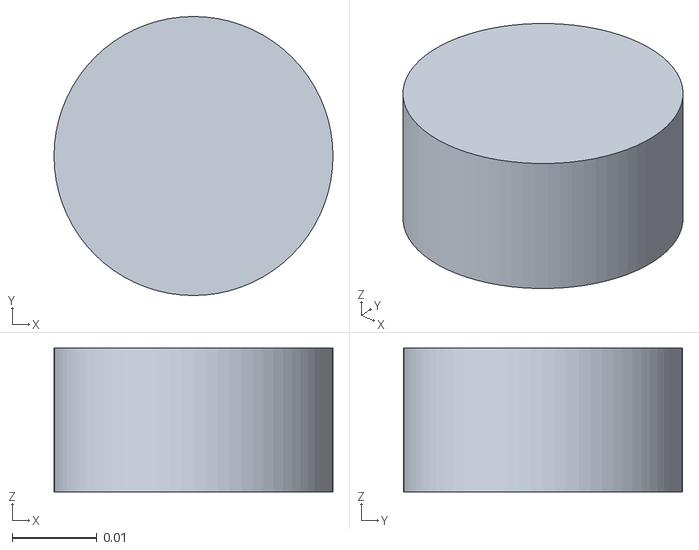
[picture p72: CAD file, 2026-09-01]
models/pengu1_05cad/assets/100g.stl
0.033 x 0.033 x 0.017
