BenGu0530/pengu/models/pengu1_05cad/assets/crank_circle.stl

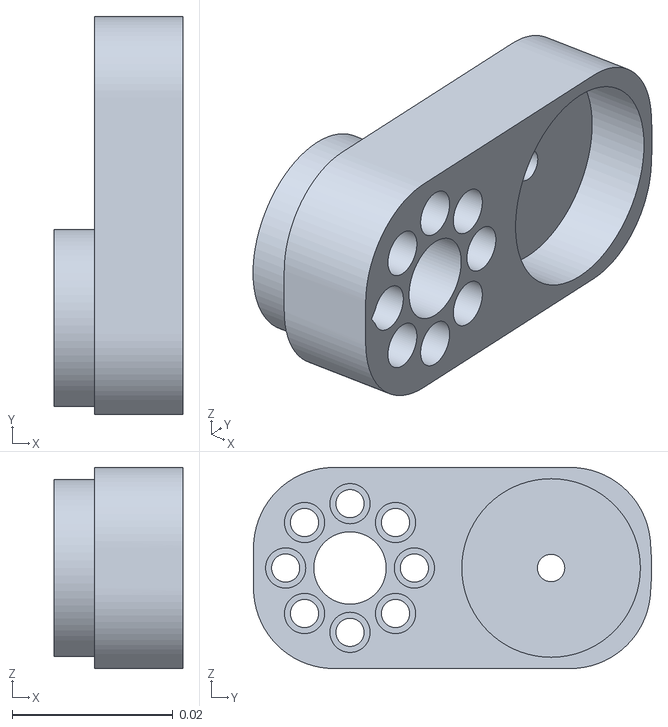
[picture p73: CAD file, 2026-09-01]
models/pengu1_05cad/assets/crank_circle.stl
0.016 x 0.0495 x 0.025
