BenGu0530/pengu/models/pengu1_05cad/assets/right_thigh.stl

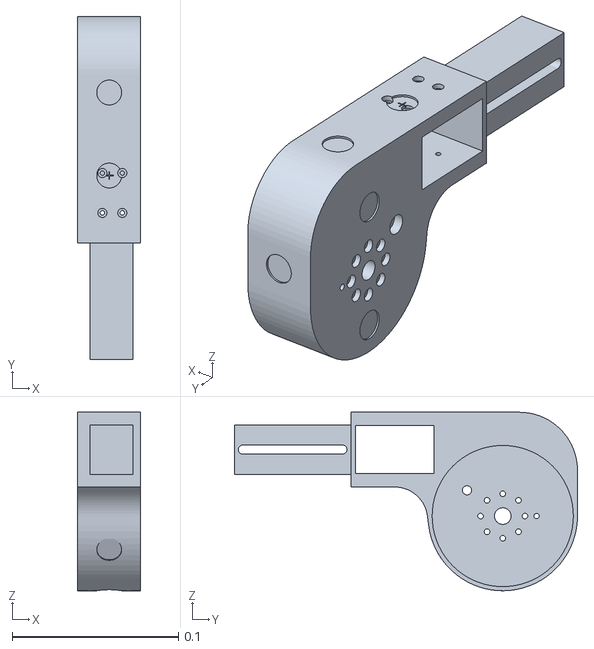
[picture p74: CAD file, 2026-09-01]
models/pengu1_05cad/assets/right_thigh.stl
0.038 x 0.207 x 0.108
