BenGu0530/pengu/models/pengu1_05cad/assets/bracketmotorside.stl

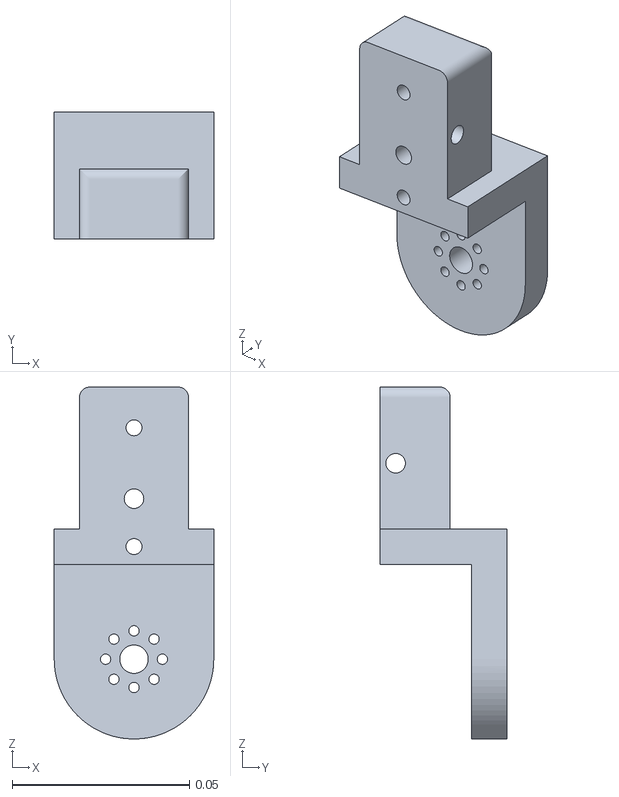
[picture p75: CAD file, 2026-09-01]
models/pengu1_05cad/assets/bracketmotorside.stl
0.045 x 0.0358 x 0.0992
