BenGu0530/pengu/models/pengu1_05cad/assets/crank_link.stl

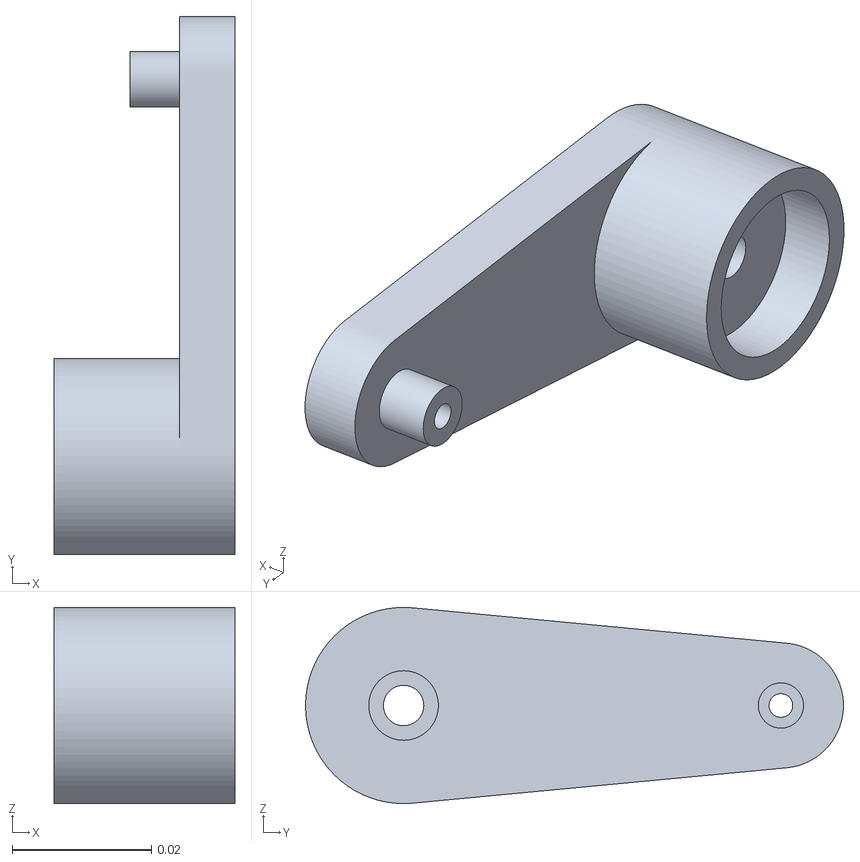
[picture p76: CAD file, 2026-09-01]
models/pengu1_05cad/assets/crank_link.stl
0.026 x 0.0773 x 0.0282
