BenGu0530/pengu/models/pengu1_05cad/assets/easymotor.stl

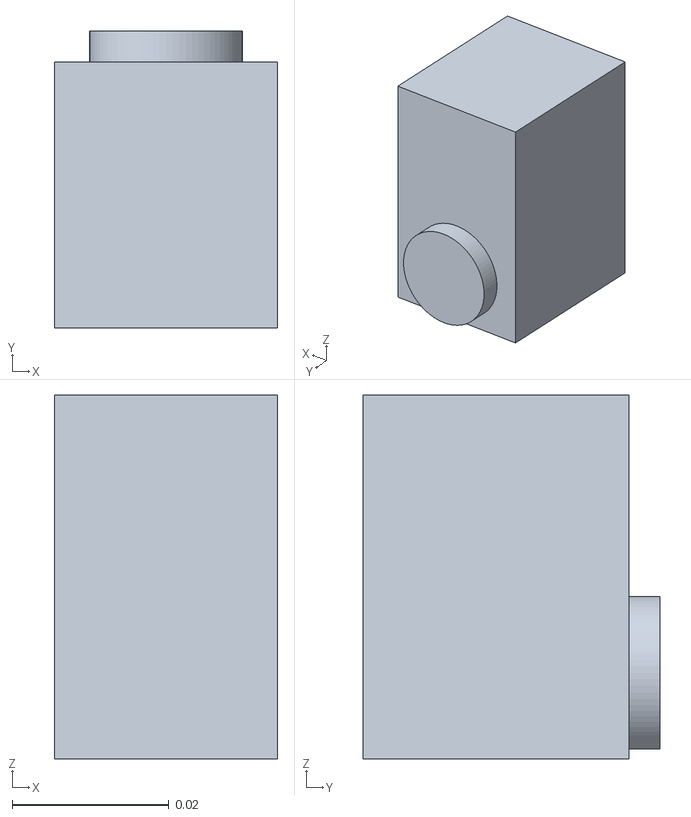
[picture p77: CAD file, 2026-09-01]
models/pengu1_05cad/assets/easymotor.stl
0.0285 x 0.038 x 0.0465
