BenGu0530/pengu/(list of files, cad)

Other CAD files:
models/pengu1_05cad/assets/right_foot0080.stl
models/pengu1_05cad/assets/battery.stl
models/pengu1_05cad/assets/left_thigh.stl
models/pengu1_10/assets/bracketbearingside.stl
models/pengu1_10/assets/bracketmotorside.stl
models/pengu1_10/assets/crank_circle.stl
models/pengu1_10/assets/crank_link.stl
models/pengu1_10/assets/easymotor.stl
models/pengu1_10/assets/easymotorwithconnector.stl
models/pengu1_10/assets/left_thigh.stl
models/pengu1_10/assets/pengu2axis010.stl
models/pengu1_10/assets/right_foot0080.stl
models/pengu1_10/assets/right_foot0080___fillet13.stl
models/pengu1_10/assets/right_thigh.stl
models/pengu1_10/assets/torso.stl
models/pengu1_40/assets/bracketbearingside.stl
models/pengu1_40/assets/bracketmotorside.stl
models/pengu1_40/assets/crank_circle.stl
models/pengu1_40/assets/crank_link.stl
models/pengu1_40/assets/easymotor.stl
models/pengu1_40/assets/easymotorwithconnector.stl
models/pengu1_40/assets/left_thigh.stl
models/pengu1_40/assets/pengu2axis010.stl
models/pengu1_40/assets/right_foot0080.stl
models/pengu1_40/assets/right_foot0080___fillet13.stl
models/pengu1_40/assets/right_thigh.stl
models/pengu1_40/assets/torso.stl
