BenGu0530/pengu/pengu_mujoco/penguV2/robot_rl.xml

<?xml version="1.0" ?>
<!-- RL variant of penguV2: the crank-slider closed loop is replaced by DIRECT
     PRISMATIC actuation of the foot sliders (leg extension = linear actuator,
     matching how the real robot's XM430 "slide" servos are commanded). This
     removes the equality (loop-closure) constraints -> open kinematic chain,
     GPU-sim friendly, faster, more stable. The closed-loop model (robot.xml)
     is kept intact for physics fidelity / sim-to-real frequency studies.

     5 actuators: hip-L, hip-R (hinge), slider-L, slider-R (PRISMATIC, leg ext),
     torso (hinge). Slider force limit = XM430 stall 4.1 N*m / ~0.025 m crank
     radius ~= 164 N -> capped at 150 N. -->
<mujoco model="penguV2_rl">
  <compiler angle="radian" meshdir="assets" autolimits="true"/>
  <option timestep="0.001" integrator="implicitfast"/>
  <default>
    <default class="penguV2">
      <joint frictionloss="0.1" armature="0.005"/>
      <position kp="50" dampratio="1" forcerange="-4.1 4.1"/>
      <default class="visual">
        <geom type="mesh" contype="0" conaffinity="0" group="2"/>
      </default>
      <default class="collision">
        <geom group="3" contype="0" conaffinity="0"/>
      </default>
      <!-- prismatic leg-extension actuator: linear-equivalent of the XM430 via
           the crank radius. kp high enough to support body weight at small error. -->
      <default class="slide_act">
        <position kp="4000" dampratio="1" forcerange="-150 150"/>
      </default>
    </default>
  </default>
  <worldbody>
    <body name="leftthighmotor" pos="0 0 0" quat="1 0 0 0" childclass="penguV2">
      <freejoint name="leftthighmotor_freejoint"/>
      <inertial pos="-0.0738509 0.0304276 -0.0227821" mass="0.207745" fullinertia="0.000560286 0.000329481 0.000281066 -2.44517e-05 1.346e-05 0.000188546"/>
      <geom type="mesh" class="visual" pos="-0.08825 0.0695744 -0.0468391" quat="0.680399 0.192502 0.192502 -0.680399" mesh="easymotor" material="easymotor_material"/>
      <geom type="mesh" class="collision" pos="-0.08825 0.0695744 -0.0468391" quat="0.680399 0.192502 0.192502 -0.680399" mesh="easymotor" material="easymotor_material"/>
      <geom type="mesh" class="visual" pos="-0.0799204 -0.0477014 -0.0456886" quat="2.22045e-16 9.51304e-16 0.487897 0.872901" mesh="left_thigh" material="left_thigh_material"/>
      <geom type="mesh" class="collision" pos="-0.0799204 -0.0477014 -0.0456886" quat="2.22045e-16 9.51304e-16 0.487897 0.872901" mesh="left_thigh" material="left_thigh_material"/>
      <body name="easyaxis" pos="-0.06925 -0.02322 4.85723e-17" quat="0.680399 0.192502 -0.680399 -0.192502">
        <joint axis="0 0 1" name="hip-L" type="hinge"/>
        <inertial pos="-0.00901156 -0.00495452 -0.06925" mass="0.345637" fullinertia="0.000743814 0.000763306 0.000118176 -1.78818e-05 -6.28834e-19 5.76195e-20"/>
        <geom type="mesh" class="visual" pos="0.00383793 0.0252541 -0.04875" quat="0.617234 0.344995 0.617234 -0.344995" mesh="pengu2axis010" material="pengu2axis010_material"/>
        <geom type="mesh" class="collision" pos="0.00383793 0.0252541 -0.04875" quat="0.617234 0.344995 0.617234 -0.344995" mesh="pengu2axis010" material="pengu2axis010_material"/>
        <geom type="mesh" class="visual" pos="0.0168353 -0.0063747 -0.0965" quat="0.344995 -0.344995 -0.617234 0.617234" mesh="easymotorwithconnector" material="easymotorwithconnector_material"/>
        <geom type="mesh" class="collision" pos="0.0168353 -0.0063747 -0.0965" quat="0.344995 -0.344995 -0.617234 0.617234" mesh="easymotorwithconnector" material="easymotorwithconnector_material"/>
        <geom type="mesh" class="visual" pos="0.00190373 0.0179008 -0.042" quat="0.617234 0.617234 -0.344995 -0.344995" mesh="easymotorwithconnector" material="easymotorwithconnector_material"/>
        <geom type="mesh" class="collision" pos="0.00190373 0.0179008 -0.042" quat="0.617234 0.617234 -0.344995 -0.344995" mesh="easymotorwithconnector" material="easymotorwithconnector_material"/>
        <geom type="mesh" class="visual" pos="0.0171129 -0.00682616 -0.0835" quat="0.680399 0.192502 -0.680399 0.192502" mesh="easymotor" material="easymotor_material"/>
        <geom type="mesh" class="collision" pos="0.0171129 -0.00682616 -0.0835" quat="0.680399 0.192502 -0.680399 0.192502" mesh="easymotor" material="easymotor_material"/>
        <body name="rightthighmotor" pos="2.63678e-16 -3.95517e-16 -0.144" quat="2.26804e-18 0.487897 0.872901 2.12453e-16">
          <joint axis="0 0 1" name="hip-R" type="hinge"/>
          <inertial pos="0.053566 -0.0228319 -0.000899096" mass="0.207745" fullinertia="0.000329729 0.000280562 0.00056003 0.000188498 2.43992e-05 -1.34921e-05"/>
          <geom type="mesh" class="visual" pos="0.0683066 -0.061901 0.0135" quat="0.680398 -0.680398 -0.192505 0.192505" mesh="easymotor" material="easymotor_material"/>
          <geom type="mesh" class="collision" pos="0.0683066 -0.061901 0.0135" quat="0.680398 -0.680398 -0.192505 0.192505" mesh="easymotor" material="easymotor_material"/>
          <geom type="mesh" class="visual" pos="-1.38778e-17 1.73472e-18 0.0155" quat="0.680398 -0.192505 0.680398 0.192505" mesh="right_thigh" material="right_thigh_material"/>
          <geom type="mesh" class="collision" pos="-1.38778e-17 1.73472e-18 0.0155" quat="0.680398 -0.192505 0.680398 0.192505" mesh="right_thigh" material="right_thigh_material"/>
          <body name="right_foot0080" pos="0.0825436 -0.0568175 -0.000350003" quat="0.680398 -0.680398 -0.192505 0.192505">
            <joint axis="0 0 1" name="slider-R" type="slide" range="-0.04987086105994058 0.00012913894005941797"/>
            <inertial pos="0.00309728 -0.00816562 -0.0519937" mass="0.149685" fullinertia="0.000166324 0.000359285 0.000426047 1.24008e-06 2.46733e-06 -8.22166e-06"/>
            <geom type="mesh" class="visual" pos="-0.000764396 0.032498 0.0472219" quat="0.5 -0.5 -0.5 -0.5" mesh="right_foot0080" material="right_foot0080_material"/>
            <geom type="mesh" class="collision" pos="-0.000764396 0.032498 0.0472219" quat="0.5 -0.5 -0.5 -0.5" mesh="right_foot0080" material="right_foot0080_material" friction="0.9 0.005 0.0001" contype="1" conaffinity="1"/>
          </body>
        </body>
        <body name="easytorso" pos="-0.0121653 0.0197781 -0.06925" quat="0.344995 0.617234 -0.344995 0.617234">
          <joint axis="0 0 1" name="torso" type="hinge"/>
          <inertial pos="1.21096e-09 -0.169903 0.0214698" mass="1.02194" fullinertia="0.00534921 0.000299527 0.00532702 -1.44594e-10 1.39433e-11 -3.05779e-05"/>
          <geom type="mesh" class="visual" pos="-0.0225 -0.17175 0.0412769" quat="0.5 0.5 0.5 0.5" mesh="part_1" material="part_1_material"/>
          <geom type="mesh" class="collision" pos="-0.0225 -0.17175 0.0412769" quat="0.5 0.5 0.5 0.5" mesh="part_1" material="part_1_material"/>
          <geom type="mesh" class="visual" pos="-4.40368e-16 -0.25175 0.0212769" quat="8.9182e-18 0 0.707107 0.707107" mesh="part_1__2" material="part_1__2_material"/>
          <geom type="mesh" class="collision" pos="-4.40368e-16 -0.25175 0.0212769" quat="8.9182e-18 0 0.707107 0.707107" mesh="part_1__2" material="part_1__2_material"/>
          <geom type="mesh" class="visual" pos="0.0225 -0.10175 0.0412769" quat="0.5 0.5 -0.5 -0.5" mesh="part_1" material="part_1_material"/>
          <geom type="mesh" class="collision" pos="0.0225 -0.10175 0.0412769" quat="0.5 0.5 -0.5 -0.5" mesh="part_1" material="part_1_material"/>
          <geom type="mesh" class="visual" pos="-0.0225 -0.31675 -0.00122307" quat="0.707107 -0.707107 -1.0103e-14 -7.95074e-18" mesh="torso" material="torso_material"/>
          <geom type="mesh" class="collision" pos="-0.0225 -0.31675 -0.00122307" quat="0.707107 -0.707107 -1.0103e-14 -7.95074e-18" mesh="torso" material="torso_material"/>
          <geom type="mesh" class="visual" pos="0.0225 -0.02675 -0.01" quat="8.32498e-18 0 0.707107 -0.707107" mesh="bracketmotorside" material="bracketmotorside_material"/>
          <geom type="mesh" class="collision" pos="0.0225 -0.02675 -0.01" quat="8.32498e-18 0 0.707107 -0.707107" mesh="bracketmotorside" material="bracketmotorside_material"/>
          <geom type="mesh" class="visual" pos="0.0225 -0.0267252 -0.01" quat="8.32498e-18 0 0.707107 -0.707107" mesh="bracketbearingside" material="bracketbearingside_material"/>
          <geom type="mesh" class="collision" pos="0.0225 -0.0267252 -0.01" quat="8.32498e-18 0 0.707107 -0.707107" mesh="bracketbearingside" material="bracketbearingside_material"/>
        </body>
      </body>
      <body name="right_foot0080___fillet13" pos="-0.0744673 0.0587954 -0.0569912" quat="2.22045e-16 4.60733e-16 -0.272239 0.96223">
        <joint axis="0 0 1" name="slider-L" type="slide" range="-0.049872120742217176 0.00012787925778282488"/>
        <inertial pos="0.00809087 -0.00363119 -0.0521227" mass="0.149685" fullinertia="0.000359248 0.000166321 0.000426014 1.24152e-06 8.21367e-06 -2.46626e-06"/>
        <geom type="mesh" class="visual" pos="-0.04257 0.00023 0.047094" quat="6.52375e-18 -0.707107 -0 -0.707107" mesh="right_foot0080___fillet13" material="right_foot0080___fillet13_material"/>
        <geom type="mesh" class="collision" pos="-0.04257 0.00023 0.047094" quat="6.52375e-18 -0.707107 -0 -0.707107" mesh="right_foot0080___fillet13" material="right_foot0080___fillet13_material" friction="0.9 0.005 0.0001" contype="1" conaffinity="1"/>
      </body>
    </body>
  </worldbody>
  <asset>
    <mesh file="right_foot0080___fillet13.stl"/>
    <mesh file="left_thigh.stl"/>
    <mesh file="right_thigh.stl"/>
    <mesh file="right_foot0080.stl"/>
    <mesh file="pengu2axis010.stl"/>
    <mesh file="easymotorwithconnector.stl"/>
    <mesh file="bracketmotorside.stl"/>
    <mesh file="torso.stl"/>
    <mesh file="bracketbearingside.stl"/>
    <mesh file="part_1.stl"/>
    <mesh file="part_1__2.stl"/>
    <mesh file="easymotor.stl"/>
    <material name="easymotor_material" rgba="0.796078 0.823529 0.937255 1"/>
    <material name="left_thigh_material" rgba="1 1 1 1"/>
    <material name="pengu2axis010_material" rgba="1 1 1 1"/>
    <material name="easymotorwithconnector_material" rgba="0.796078 0.823529 0.937255 1"/>
    <material name="right_thigh_material" rgba="1 1 1 1"/>
    <material name="right_foot0080_material" rgba="1 1 1 1"/>
    <material name="part_1_material" rgba="0.615686 0.811765 0.929412 1"/>
    <material name="part_1__2_material" rgba="0.615686 0.811765 0.929412 1"/>
    <material name="torso_material" rgba="1 1 1 1"/>
    <material name="bracketmotorside_material" rgba="1 1 1 1"/>
    <material name="bracketbearingside_material" rgba="1 1 1 1"/>
    <material name="right_foot0080___fillet13_material" rgba="1 1 1 1"/>
  </asset>
  <actuator>
    <position class="penguV2" name="hip-L" joint="hip-L" ctrlrange="-1.5708 1.5708"/>
    <position class="penguV2" name="hip-R" joint="hip-R" ctrlrange="-1.5708 1.5708"/>
    <position class="slide_act" name="slider-L" joint="slider-L" inheritrange="1"/>
    <position class="slide_act" name="slider-R" joint="slider-R" inheritrange="1"/>
    <position class="penguV2" name="torso" joint="torso" ctrlrange="-0.7854 0.7854"/>
  </actuator>
</mujoco>
