BenGu0530/pengu/(commit log)

2026-04-13 Initial commit: pengu Arduino project
2026-04-13 Reorganize: move Arduino sketches into Arduino/, add penguV2 MuJoCo model and launch_pengu.py
    [bracketbearingside.stl, bracketmotorside.stl, crank_circle.stl, crank_link.stl, easymotor.stl, easymotorwithconnector.stl, left_thigh.stl, part_1.stl]
2026-04-13 Move MuJoCo files into pengu_mujoco/
    [bracketbearingside.stl, bracketmotorside.stl, crank_circle.stl, crank_link.stl, easymotor.stl, easymotorwithconnector.stl, left_thigh.stl, part_1.stl]
2026-04-13 Add MuJoCo stand/walk/sweep scripts for EasyPengu
    [sweep_freq_results.csv]
2026-04-13 Move stand/walk/sweep scripts into pengu_mujoco/
    [sweep_freq_results.csv]
2026-04-16 Add penguV2 model + refactored gait controller
    - gait_config.py: all tunable params + controller (single source of truth)
    - walk_pengu.py: viewer, imports from gait_config
    - plot_actual_gait.py: headless sim + cmd vs actual plots
    - penguV2/: robot.xml, scene.xml, STL meshes
    - backup_scripts/: old standalone scripts
    - Optimal freq from sweep: 1.64 Hz
    [bracketbearingside.stl, bracketmotorside.stl, crank_circle.stl, crank_link.stl, easymotor.stl, easymotorwithconnector.stl, left_thigh.stl, part_1.stl]
2026-04-16 Move all scripts to pengu_mujoco/, add refactored gait controller
    [sweep_freq_results.csv]
2026-04-16 Rename nested pengu_mujoco to backup_scripts
    [sweep_freq_results.csv]
2026-04-16 Clean up: remove old scripts, move swing_walk to backup
    [sweep_freq_results.csv]
2026-05-10 Add physics ID experiments and reorganize plotting scripts
    - physics/physics.py: torso direction probe + frequency sweep
    - physics/air_probe.py: zero-gravity per-DOF kinematic probe
    - physics/ideal_gait_signals.py: moved from root, renamed
    - actual_gait_plot.py: renamed from plot_actual_gait.py
    - walk_pengu.py: per-DOF static-hold debug mode + decoded torso tilt readout
    - gait_config.py: phase offset adjustments from physics ID findings
    - .gitignore: exclude MuJoCo logs, pyc, sweep outputs
2026-06-01 Add per-surface friction switching for surface ablation
    - robot.xml: explicit sliding friction 0.9 on the two foot collision geoms
    (right_foot0080 = right foot, right_foot0080___fillet13 = left foot);
    visual geoms and all other collision geoms left at MuJoCo default.
    - scene.xml: explicit floor friction, 0.5 = mocap-floor baseline, switchable
    to acrylic/UHMW-PE/PTFE by editing one number.
    - friction_utils.set_floor_friction(): runtime floor-mu override for sweeps,
    plus SURFACES dict of the 4 ablation coefficients.
    Model: foot mu (0.9) > floor mu, so the floor dominates MuJoCo's min() contact
    pair and is the single variable for the ablation.
    [robot.xml, scene.xml]
2026-06-01 Add frequency x surface sweep infrastructure
    - sweep_freq_surface.py: new headless freq x surface batch sweep. Uses the
    current gait (gait_config.apply_ctrl, like walk_pengu.py) and per-trial floor
    friction override via friction_utils.set_floor_friction (fresh model per
    trial). Background-friendly: per-trial try/except (one bad trial can't kill
    the run), incremental results.csv + progress.log flush, timestamped results/
    dir, summary.txt + summary_plot.png at end, matplotlib Agg (no display).
    Restores gait_config.WALK_FREQ in finally.
    - gait_config.py: add set_walk_freq(hz) runtime setter; file default 1.64 kept.
    - scene.xml + friction_utils.py: baseline mocap-floor mu 0.5 -> 0.7.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
    [scene.xml]
2026-06-02 Add anchor-validation freq sweep + headless/setter prereqs
    sweep_anchor_validation.py: two independent 1D fine-frequency sweeps
    (0.01 Hz step, 1.0-2.2 Hz) for the known real-robot walking anchors
    (hip_only: hip=11deg; crank_only: crank=104deg), single mocap_floor
    surface. Reuses gait_config.apply_ctrl; logs survival, fwd/lat distance,
    torso roll amp, and pitch drift per trial; incremental CSV flush, per-trial
    try/except, try/finally restore of all mutated gait globals.
    gait_config.py: add set_hip_amp/set_crank_amp/set_torso_amp runtime setters
    (mirror set_walk_freq); file defaults unchanged.
    actual_gait_plot.py, physics/physics.py, physics/air_probe.py: set the Agg
    matplotlib backend befor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
2026-06-02 Split ambiguous pitch_drift_deg into signed offset + amplitude
    pitch_drift_deg took abs() of the spawn-relative root-body pitch, destroying
    sign so a value could not be read as "more forward" vs "recovering". Replace
    it with two metrics over the same settle window roll uses:
    - pitch_offset_deg: signed, most-extreme deviation from spawn pitch
    (+ = leaning more forward than spawn, - = recovering toward upright)
    - pitch_amp_deg: pitch oscillation amplitude (peak-to-peak / 2)
    torso_roll_amp_deg unchanged.
2026-06-12 Add CPG-RL penguin gait: bio-imitation env, training, metrics
    - rl/pengu_env.py: CPG-RL Gym env (prismatic + crank), phase-latched
    rhythm, nominal-centered actions, bio_imitate mode for penguin-prior
    gait (cadence/roll/lean imitation reward) + swing-protraction propulsion.
    - rl/train_penguin.py + train_curriculum.py: PPO training (DR, curriculum,
    periodic bio-signature eval, checkpointing).
    - rl/penguin_metrics.py: gait "ruler" vs real king-penguin (stride freq,
    waddle roll/lean amp, Griffin-Kram energy recovery, lateral KE fraction).
    - rl/render_views.py + render_with_trajectory.py: multi-angle / footstep-
    trajectory rendering with configurable camera.
    - penguV2/robot_rl.xml + sce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
    [robot_rl.xml, scene_rl.xml]
2026-06-12 Make penguin bio-reward variant switchable (v3 waddle / v4 propulsion)
    Add `propulsion` flag to PenguCPGEnv so both result-sets live in the repo:
    - v3 (propulsion=False): clean slow waddle, cleanest lean, rocks ~in place
    (lateral KE ~76%).
    - v4 (propulsion=True, default): adds r_swing (swing foot reaches forward ->
    the rock becomes a step), shifting lateral KE 76%->47%.
    train_penguin.py takes a 3rd CLI arg (v3|v4) and tags saved model/checkpoints
    per variant so they no longer overwrite each other.
2026-06-12 Add trained v3 penguin policy (ppo_penguin_v3.zip)
    Curated deliverable: best v3 bio-imitation policy (cadence 1.33 Hz, roll 8.7,
    lean 1.9, surv 1.0). Track small SB3 policy zips under rl/models/ via a
    .gitignore allowlist exception; generated runs/ artifacts stay ignored.
2026-06-12 Add trained v4 penguin policy (ppo_penguin_v4.zip)
    Curated deliverable: best v4 propulsion policy (cadence 1.30 Hz, roll ~8-11,
    lateral KE 76%->47% vs v3 — rock converted toward forward stepping, surv 1.0).
    Repo now carries both v3 (clean waddle) and v4 (propulsion) policies.
2026-07-05 Add physics gait pipeline + torso-mode friction experiments (v3)
    Track the previously-untracked open-loop gait pipeline (gait_sweep, cma_search,
    gait_report, analyze_gait, grf_friction_probe, heatmaps, friction_study, run_grid,
    fine3_guard) plus the penguV3 model (scene/robot xml + STL assets; media excluded).
    New experiments (Fable advisory session):
    - physics/killtest_torso_modes.py: gait A/B held FIXED, torso flipped x mu ladder.
    Proves upright/over_swing are NOT reachable by flipping torso on a fixed over_stance
    gait (the gait stops walking) -> the 3-mode comparison must re-optimize per mode.
    - physics/matched_speed_v3.py: per-mode re-optimization to matched speed 0.08 m/s on v3.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
    [bracketbearingside.stl, bracketmotorside.stl, crank_circle.stl, crank_link.stl, easymotor.stl, easymotorwithconnector.stl, left_thigh.stl, part_1.stl]
2026-07-05 Force-track key results registries + friction CSVs past results/ gitignore
    BEST_GAITS.md and SWEEP_ANALYSIS.md are hand-written registries (not artifacts) and
    were invisible cross-machine. The three friction CSVs are the paper-critical data
    (v2 matched-speed, v3 kill test, v3 matched-speed maxfev=140 baseline). Once tracked,
    future edits commit normally without -f.
    [killtest_v3_AB.csv, matched_speed_v3.csv, penguin_configs.csv]
2026-07-06 matched_speed_v3 run from Mac (maxfev=400)
    Overwrites the maxfev=140 baseline (kept in history at 970c1fa) with a
    larger-budget run, same v3 config / seed=1.
    mode mu_req_p95 min_mu speed
    upright 0.631 0.5 0.080
    over_stance 0.573 0.06 0.080
    over_swing 0.510 - 0.073
    vs maxfev=140 baseline (upright 0.625 / over_stance 0.523, gap 1.20x):
    at 400 the gap is 1.10x. over_stance mu_req rose 0.523->0.573 because the
    140 over_stance undershot target speed (0.0795) while 400 hits 0.080
    exactly, so 400 is the fairer matched-speed point. Claim over_stance <
    upright still holds; margin is budget-sensitive. min_mu story strengthens
    (over_stance now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
    [matched_speed_v3.csv]
2026-07-06 v3 matched-speed: 5-seed sweep kills the mu_req claim (mean 0.94x, 2/5)
    Ran matched_speed_v3.py 400 1,2,3,4,5 on Mac. All 5 seeds matched speed
    (0 excluded by the speed gate). Speed-gated cross-seed verdict:
    seed 1 2 3 4 5 mean±std
    upright 0.631 0.397 0.469 0.448 0.620 0.513±0.106
    over_stance0.573 0.534 0.540 0.551 0.527 0.545±0.018
    gap 1.10 0.74 0.87 0.81 1.18 0.94x±0.19
    over_stance wins only 2/5; mean gap 0.94x (reversed). The 1.10x/1.20x
    single-seed advantage was an artifact of upright's multi-modality at
    matched speed: CMA finds a low-friction high-freq upright gait
    (mu_req 0.40-0.47) in 3/5 seeds, the high-friction basin in 2/5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
    [matched_speed_v3_mf400_agg.csv, matched_speed_v3_mf400_s1.csv, matched_speed_v3_mf400_s2.csv, matched_speed_v3_mf400_s3.csv, matched_speed_v3_mf400_s4.csv, matched_speed_v3_mf400_s5.csv]
2026-07-06 Gait-family torso study + COM-variant prototype; seed-variance verdict data
    - results: local seeds 6-10 (mf400, matched speed). mu_req_p95 verdict REVERSES
    across seeds (over_stance wins only 2/6 incl Mac s1; gap 0.92x +/- 0.25) ->
    demoted to diagnostic. min_mu_to_walk is seed-robust: over_stance <= upright
    in 6/6 seeds -> becomes the headline readout (peak demand != slip robustness).
    - physics/gait_family_torso_study.py: does the over_stance min_mu advantage
    generalize across fine3c families (hip_phi 210/110/270)? Adds per-family
    torso-phase calibration via instrumented torso_stance_corr rollout; smoke run
    showed family 210's true phi_swing = 225 (not the assumed 180).
    - physics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
    [matched_speed_v3_mf400_s10.csv, matched_speed_v3_mf400_s6.csv, matched_speed_v3_mf400_s7.csv, matched_speed_v3_mf400_s8.csv, matched_speed_v3_mf400_s9.csv]
2026-07-06 Gait-family torso study results: min_mu advantage is NOT family-universal
    3 families (hip_phi 110/210/270) x 3 seeds x mf400, all speed-matched.
    - Per-family torso-phase calibration confirms phi_stance differs by family
    (0/225/270 deg) -> torso_phi=0 != "over stance" outside the 210 family.
    - min_mu(over_stance) < min_mu(upright) in families 110 & 210 (3/3 each) but
    REVERSES in 270 (over_stance forced to high freq to match speed). So the
    friction benefit is gait-regime dependent, not universal.
    - ROBUST across all families/seeds: torso_stance_corr(over_stance) ~0.83 (small
    std) -> the penguin posture is realized everywhere; friction help is a
    gait-dependent by-product. Reframes the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
    [gait_family_mf400_agg.csv, gait_family_mf400_s1_phi110.csv, gait_family_mf400_s1_phi210.csv, gait_family_mf400_s1_phi270.csv, gait_family_mf400_s2_phi110.csv, gait_family_mf400_s2_phi210.csv, gait_family_mf400_s2_phi270.csv, gait_family_mf400_s3_phi110.csv]
2026-07-06 GRID-2 Stage A implementation: grid2_sweep.py + run_grid2.sh launcher
    2,225,232 cells (freq 1.00-2.00@0.01, hip_phi@10, amps coarse, torso_amp{0,10,20}
    with torso_phi collapse at amp=0, hip_off{10,20,30,40}), penguV3, mu=0.7.
    Clones gait_sweep harness semantics (initcsv/resume/modulo-shard/sentinels),
    reuses run_trial verbatim. 2-shard smoke test passed (18-cell grid, collapse
    correct, gait-B cell reproduces net_fwd~0.21). NOT launched - awaiting GO.
2026-07-08 GRID-2 Mac shards 12-15 complete (csv.gz)
    Mac's 4/16 share of Stage A done. Verified before ship:
    - 556,308 data rows = exact expected share (2,225,232 * 4/16)
    - 0 malformed rows (22 fields each)
    - 556,308 unique 7-tuples = zero duplicate cells
    - all 4 .shard{12,13,14,15}of16.done sentinels present
    63M raw -> 15M gz. Linux side (shards 0-11) merges: concat + de-dupe
    by the 7 axis columns, check total row count = 2,225,232, then Stage B.
2026-07-08 GRID-2 Stage A complete: merged 2,225,232 cells (local 0-11 + Mac 12-15)
    Verified: 0 duplicate 7-tuples, count exact. First landscape (μ=0.7, 484k clean
    walkers): mean μ_req_p95 rises with torso_amp (upright 0.479 < t10 0.507 < t20
    0.545) — the μ_req 'penguin advantage' is falsified at grid scale on v3 (NOT yet
    speed-matched; min_mu is Stage B). Column order note: single_frac is CSV col 14.
2026-07-09 GRID-2 Stage B: min_mu ladder + corr + foot roll/pitch on 484k clean walkers
    stage_b_minmu.py: per clean-walker, instrumented rollout @mu=0.7 (torso_stance_corr,
    foot_roll_amp, foot_pitch_amp) + mu ladder 0.5->0.06 (min_mu, clean-walk contiguous).
    Shares grid2_cleanwalkers.csv.gz (484,157 rows) so Linux 0-11 + Mac 12-15 index the
    same list. Smoke (24 cells) passed. Linux launched (~25h/363k share).
    Mac runbook: docs/stageB_mac_memo.md.
2026-07-10 Stage B Mac shards 12-15 (min_mu + corr + foot roll/pitch)
    Mac's 4/16 share of Stage B done. Verified before ship:
    - 121,037 data rows = exact shards-12-15 share
    - 0 malformed (14 fields), 121,037 unique 7-tuples (no dupes)
    - 0 nan torso_corr (all instrumented rollouts succeeded)
    Preview on this slice (corr-classified, speed-matched 0.10-0.14 m/s band):
    over-stance (corr>=+0.3) mean min_mu 0.39 vs neutral 0.48 — over-stance
    walks on lower mu at matched speed, and is slightly FASTER not slower
    (not a speed artifact). The min_mu/slip-robustness signal holds where the
    matched-speed mu_req_p95 reversed on v3. Real test = the speed-binned
    analysis on the merged 484k.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
2026-07-17 Add CLAUDE.md: working agreement + co-design project frame
    Working agreement (Ben's rules): draw no conclusions; never interrupt/write off a
    sweep before all sweeps finish; simulation only (no real-robot pressure); Ben decides
    direction.
    Project frame: co-design over COM/hip-axis ratio (1.05/1.2/1.4/1.6) x torso control
    (PID upright / PID lean-to-stance / no torso), + foot gap, foot geometry, surfaces.
    Flags two things to resolve: (1) BEST_GAITS.md:3 records the model as COM/leg=1.05
    '(penguin)' which conflicts with the spec 1.05=human/1.6=penguin; (2) easytorso is a
    child of easyaxis so torso_amp=0 is the fixed-joint case (rolls WITH the axis), not
    the world-upright Gait 1 — Gait 1/2 nee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
2026-07-17 GRID-2 Stage B complete: all 484,157 clean walkers measured
    16/16 shards, 0 duplicate 7-tuples. Per cell: min_mu_to_walk (clean-walk contiguous),
    torso_stance_corr, foot_roll_amp, foot_pitch_amp (atan2 unwrap fix applied; the 11,486
    pre-fix wrapped/malformed rows were dropped and recomputed).
    Replaces the Mac-shards-only gz with the merged complete dataset. Not analyzed.
2026-07-17 CLAUDE.md: no species labels on parameters; COM ratio measured; torso kappa plan
    - Naming rule: never label a parameter value penguin/human. Numbers only
    (COM ratio 1.05/1.2/1.4/1.6, Gait 1/2/3, foot gap 80/100mm).
    - COM ratio definition = whole-robot COM height / hip-axis height above floor at
    neutral stand. Measured: penguV3 today = 1.108 (COM 0.1881 / axis 0.1697) -> the
    current model sits at the LOW end; variants must push the ratio UP.
    - Open for Ben before CAD: raise ratio by moving mass up vs shortening legs (same
    ratio, different robots); canonical measurement pose; whole-robot vs upper-body COM.
    - Torso control: continuous follow-gain kappa (target torso world roll = kappa x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
2026-07-17 Add reactive torso control: the kappa follow-gain law (Gait 1/2 prerequisite)
    torso_control.TorsoKappaPID: target torso tilt = kappa * hip-axis tilt, outer-loop PID
    on the torso joint. kappa=0 -> Gait 1 (world-upright), kappa=1 -> the old fixed-joint
    case, kappa>1 -> Gait 2 (leans further into the roll). gait_config gains an optional
    TORSO_CONTROLLER hook; when None (default) behaviour is bit-identical (regression:
    gait B reproduces net_fwd 0.2149 exactly).
    Two bugs found by measurement, not assumption:
    1. SIGN: a static joint sweep gives d(tilt)/d(joint) = -1 in the world-frame measure,
    so the first feedforward pushed the wrong way (83% saturation).
    2. FRAME: a world-frame lateral-tilt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
2026-07-20 GRID-3 kappa=0 sweep: one co-design cell, torso PID Gait 1
    Selected cell: penguV3, COM ratio 1.108 (current), foot gap current, floor mu=0.7,
    torso control kappa=0 (world-upright PID). Swept freq(101) x hip_phi(36) x
    leg_amp{85..125}(5) x hip_amp{12..28}(5) x hip_off{10..50}(5) = 454,500 cells.
    Open-loop torso axes (torso_amp/torso_phi) replaced by the fixed-kappa PID.
    grid3_kappa_sweep.py reuses run_trial + gait_sweep harness (initcsv/resume/shard/
    sentinels); records two extra readouts: torso_roll_rms (Gait-1 benchmark, smoke
    showed ~1 deg = torso held) and torso_sat_frac (0.0 at this COM, motor not binding).
    torso_control gains measure_after so roll_rms is over the walk window only.
    run_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
2026-08-04 GRID-3: slip + heading + DR metrics; k0/k1.5/k2 complete (29-col)
    Metrics added to gait_sweep.run_trial (all appended, earlier columns unchanged):
    - slip_dist / slip_ratio: planted-foot sliding on the ground (foot-slip, not net-fwd),
    slip_ratio = total slide / total stride; gate for 'does it actually grip'.
    - heading_align: base-front . travel direction in [-1,1]. Catches gaits that score
    net_fwd>0 while facing BACKWARD (moonwalk) -- ~36% of 'valid' k0 cells were retrograde.
    - POSE_JITTER hook for initial-pose domain randomization (default None = bit-identical).
    New tooling:
    - grid3_dr_sweep.py: in-the-loop DR re-sweep of k0 (Gait 1), K=5 randomized repeats/cell
    (mu~U(.45,.9), torso m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
2026-08-13 DR sweep: KAPPA env switch (k0dr/k2dr) + one-line portable run_sweep.sh
    grid3_dr_sweep.py now reads KAPPA (default 0 = Gait 1, unchanged) and bakes it
    into the filename tag, so the same script runs k0dr and k2dr with no edit.
    run_sweep.sh: CPU-only bootstrap for a fresh clone — auto-finds/creates a python
    with mujoco+numpy+cma, recovers the committed .gz snapshot, initcsv, launches
    cores-2 shards. Resume is by axis-tuple; DR seeded by cell index (machine-independent).
2026-08-14 Add Onshape-exported models 1.05/1.20/1.31 (MuJoCo + URDF) with inventory memo
    Pull three Pengu CAD revisions from Onshape via onshape-to-robot 1.8.2 and
    export each to both MuJoCo and URDF. Both formats share one assets/ dir per
    model, which works because MuJoCo's meshdir="assets" and the URDF's
    package://assets/... both resolve relative to the model dir; this halves
    on-disk size (11 MB vs 21 MB with duplicated STLs).
    The three models are one robot with a swept counterweight, not distinct
    designs. Total mass steps by exactly 0.250 kg per rung and COM height with
    it:
    1.05 (= V3) 1.7724 kg COM z +0.00811 m
    1.20 2.0224 kg COM z +0.03230 m
    1.31 2.2724 kg COM z +0.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
    [bracketbearingside.stl, bracketmotorside.stl, crank_circle.stl, crank_link.stl, easymotor.stl, easymotorwithconnector.stl, left_thigh.stl, part_1.stl]
2026-08-14 walk_pengu: side-tracking follow camera; promote iykyk_pengu out of backup
    Rework walk_pengu.py from per-joint static holds into a passive viewer with
    a follow camera that sits 2 m off the robot's left side and tracks the
    torso. Yaw is recovered by caching the body-frame direction pointing world
    +y at init and re-projecting it through the torso xmat each frame, so it
    holds regardless of which torso axis is nominally forward; roll and pitch
    are ignored. Adds Space/F/Esc hotkeys for pause, follow-cam toggle and quit.
    Move iykyk_pengu.py from backup_scripts/ back into pengu_mujoco/ unchanged.
2026-08-14 Harden COM-ladder models 1.20/1.31 to the penguV3 5-actuator convention; wire into sweeps
    Apply the exact penguV3 hardening recipe to models/pengu1_20 and models/pengu1_31
    (raw onshape exports kept as robot_raw_export.xml): implicitfast + 1ms timestep,
    XM430 forcerange +-4.1, contact only on the feet with the standard foot friction,
    and the 5-actuator driven set (crank disks via the connect-equality loop; the raw
    9-actuator export double-drove the closed chain and remapped crank1-R).
    Verified: com_ratio/mass identical pre/post hardening (1.179/2.022 kg, 1.286/2.272 kg
    vs penguV3 = 1.045/1.772 kg); nu 9->5; smoke DR runs walk on 1.20.
    gait_config: PENGU_MODEL=1.20|1.31 -> repo-root models/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
    [robot.xml]
2026-08-15 GRID-4: gait x friction co-design sweep (c1-c6)
    Base model for all configs = hardened models/pengu1_31 (native 2.2724 kg, matches
    the physical build). COM ladder {1.05, 1.20, 1.31} built at load time by sliding
    easytorso's inertial COM along the counterweight axis (bisection; total/per-link
    mass, geometry, actuation untouched). mu joins the sweep as a 6th axis
    {0.1, 0.3, 0.5, 0.7} with relative +-5% per-trial jitter; K=5 pose-jittered
    repeats, seeded per (cell, mu, rep); no mass jitter. Pass = survive AND forward
    heading AND net_fwd > 0.05; slip is recorded, not gated.
    run_sweep.sh gains c1..c6 jobs (grid3 k0dr/k2dr kept as legacy resume only);
    docs/grid4_guide.md supersedes the grid3 memos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
2026-08-16 Fleet fixes from machine B/C memos: -u shard stdout, .sweep_venv gitignore, WSL keepalive + probe + exact slides in docs
2026-08-16 GRID-4: CSV header is required for resume; fix probe-before-launch trap
    The zero-row COM probe opens the CSV with mode 'a' and creates a 0-byte file, so
    the later initcsv skips the header (guarded by 'if not os.path.exists'). Without a
    header, _load_done reads via csv.DictReader, takes row 1 as the field names, and
    recovers 0 done rows -- every restart re-runs from scratch and appends duplicates.
    Reorder the pre-flight so the probe runs after the launcher, add a header check +
    repair step to the fleet pre-flight, and note the failure mode in the guide.
    Machine D: record the actual repo path (not ~/pengu), 14 shards, and exact-argv
    process counting/killing (pgrep -f grid4_sweep.py matches t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
2026-08-16 Staged-K: sweep the map at K=1, top up hot regions to K=5 with topup_k.py
    Seeds are per (cell, mu, repeat), so a K=1 sweep is exactly trial r=0; topup_k.py
    runs r=1..4 for selected rows and merges with the stored aggregates. Validated on
    the smoke grid: merged rows are identical to a native K=5 run (worst diff 0.0).
    Fleet memo: amendment + switch procedure for B/C; ~5x faster map (~1.5-2 weeks
    for all six configs on the current fleet).
2026-08-16 Fleet memo: staged-K switch procedure covers D (shared box: argv-exact kill + nice 19)
2026-08-16 GRID-4 c2: archive 22,496-row K=5 partial before staged-K switch
2026-08-16 machine B memo: staged-K switch, 13.9h K=5 rate, K=1 at 7.5k rows/h, shard count is flat
2026-08-16 GRID-4 c3: memo update -- resume bug, keepalive, corrected rate
    Adds the grid4_sweep resume crash and its fleet-wide blast radius, the
    three-layer keepalive installed on this machine and how it was verified, and
    corrects throughput to the cumulative hour-scale figure (~3440 rows/h, ~22 d)
    rather than the two short samples.
2026-08-16 GRID-4 c3: staged-K switch, 20 cores, watchdog fd-leak fix
    Machine C is now on K=1 with 20 shards and all 20 vCPU; the K=5 partial
    (35,005 rows) is archived as .k5partial and was never mixed in. Measured
    ~20,320 rows/h, ETA ~3.7 d, which agrees with the fleet memo estimate.
    Also records the watchdog lock-fd leak (shards inherited the flock fd, so
    shard-death recovery had gone silently dead and any blocking flock deadlocked),
    the ~10 h idle window after the 03:34 reboot because the Windows task triggers
    at logon, the active-hours change that explains why that reboot happened at
    03:34, and the PowerShell metacharacter trap when driving wsl.exe.
2026-08-17 Fix resume NameError: progress print referenced 'row' before any new cell ran
    On relaunch with existing rows, a shard whose first 25+ cells are already done never
    defines 'row', and the periodic progress print crashes the shard (machine-C finding,
    reproduced+verified there; smoke-verified here: fully-done shard now resumes clean).
    Same guard applied to the legacy grid3_dr_sweep.py.
    Machine C carries a local commit with its own version of this fix -- rebase there;
    drop the local commit if it conflicts (git rebase --skip).
2026-08-17 Fleet: machines E/F take c5/c6; run_sweep.sh defaults GRID-4 jobs to DR_K=1 (staged-K)
2026-08-17 run_trial: displacement-weighted support split (ds_move_frac / ss_move_frac)
    ds_move_frac = base travel while BOTH feet are loaded / total travel in the
    measurement window (ss_move_frac = single-support share). Complements the
    time-weighted single_frac and the contact-point slip_ratio: low ds_move_frac =
    travel happens in single support (conventional stepping), high = double-support
    shuffle. Returned by run_trial only -- no sweep CSV schema change; in-flight
    GRID-4 files unaffected. Measured on the two c1 demo gaits: mu=0.1 shuffle
    0.830, mu=0.7 stepper 0.174.
2026-08-19 grid4_report.py: living analysis report (heatmap wall, volume/speed vs mu, overlap matrix, freq-edge table, top-gait csvs)
2026-08-19 GRID-4 analysis package (report + finalists + demos)
    [finalists.csv, top_gaits.csv]
2026-08-19 run_sweep.sh: pick_py requires mujoco 3.8.x (protocol engine pin)
    rml3's system python3 carries mujoco 3.10.0 and was silently selected for the c2
    continuation -- different engine version than the fleet's 3.8.1. The launcher now
    rejects non-3.8 pythons and falls through to building the pinned .sweep_venv.
2026-08-19 GRID-4 c1 partial snapshot (1524017 rows) — Mac hands c1 to rml2
2026-08-20 GRID-4 analysis: rerun over 5 configs, demos at every mu, organized package
    Rerun the analysis with c1 included (was 4 configs, now 5: c1, c3, c4, c5,
    c6). c2 is still partial at 264,949/1,818,000 rows and is auto-skipped; the
    whole package needs another rerun once it lands.
    Add physics/grid4_demos.py: renders the #1 gait of each config at EVERY mu
    level, not just mu=0.1. grid4_finalists.py is left alone and now run with
    --no-demo, so the two do not duplicate rendering. 20 clips total (5 configs
    x 4 mu), side+back, 1280x480, 30fps, 24s, nominal conditions -- so each clip
    corresponds 1:1 with the rank=1 row of that config's finalists.csv.
    Reorganize per-config output into cN/demos/ and add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
    [finalists.csv, top_gaits.csv]
2026-08-20 INDEX.md: correct the finalist table — valid is a stepping gate, not pass
    The previous INDEX.md (and my reading of it) treated finalists.csv `valid` as
    the pass criterion. It is not. The two pipelines gate differently:
    map pass = survived AND heading_align>0.5 AND net_fwd>0.05
    final valid = survived AND n_steps[L]>=2 AND n_steps[R]>=2 AND ...
    valid requires at least two discrete steps per leg, so a robot that slides
    forward without stepping scores pass=1, valid=0. The apparent c1 "inversion"
    in the previous version was this mismatch, not a physical effect: c1's top-20
    score 20/20 on the map at mu=0.1 and 0/20 on valid, because at mu=0.1 c1
    advances by shuffling (ds_move_frac 0.766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
2026-08-20 gait_probe.py: single-gait trajectory probe; c6 low-freq demo
    Add physics/gait_probe.py — runs one gait and reports where the travel
    actually goes: net forward (y) vs net lateral (x) from the base freejoint,
    path length, heading angle off the forward axis, plus the walk-quality
    metrics. Optional --demo renders that gait.
    Motivation: c6's rank-1 gait (freq 1.96) looks like it walks sideways in the
    demo, and it does. Measured over 24 s at mu=0.1 nominal:
    net forward +2.34 m, net lateral +8.81 m -> 3.76x more sideways
    heading 75.1 deg off the forward axis
    base-trajectory straightness 0.954 (a clean straight line, just aimed wrong)
    It still passes the map gate because pass only needs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
2026-08-20 yaw_probe.py: track base yaw/xy through hold->blend->walk, with --hold override
2026-08-20 staged_start_probe.py: ramp hip_off in slowly, settle, then walk
    Ben's observation: compute_gait applies hip_off WITHOUT the alpha blend --
    hip_L = hip_off - hip_lean + alpha * hip_amp * max(0, sC)
    -- so at the first instant of the blend the hip command steps by the full
    hip_off. A 30 deg offset is a 30 deg step input, which is a shove, not a
    walking test.
    This probe separates the two: ramp hip_off 0->full over --ramp seconds, hold
    at the offset for --offsettle seconds until the rocking decays, then blend the
    oscillation in. --abrupt reproduces the original behaviour.
    Validated: --abrupt at hip_off=20 gives 6.89 m upright at +43.2 deg, matching
    gait_probe's 7.35 m / +42.0 deg on the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
2026-08-20 Correct the staged-start claim: the robot DOES self-start
    The previous commit (92c9112) concluded from one gait that "the gait appears
    to depend on the start transient to enter its limit cycle rather than
    self-starting from a settled pose". That over-generalised from a single
    low-frequency gait and is wrong.
    Running staged vs abrupt on all five configs' rank-1 gaits at mu=0.1
    (15 s of walking measured after the blend):
    cfg gait freq/phi/leg/hip/off ABRUPT STAGED
    c1 1.8/260/125/20/50 2.50 m UPRIGHT 2.52 m UPRIGHT
    c3 1.9/280/105/28/10 2.49 m UPRIGHT 2.48 m UPRIGHT
    c4 1.8/340/115/28/10 5.01 m UPRIGHT 4.87 m UPRIGHT
    c5 1.94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
2026-08-20 Staged-start finalist re-run + cross comparison figures
    Re-run all five configs' top-20 at every mu with a SLOW start and compare
    against the original abrupt start.
    grid4_finalists_staged.py monkeypatches gait_config.apply_ctrl and extends
    T_HOLD to 5+ramp+settle, so run_trial's measurement window shifts with it and
    the measured walking duration stays identical to the original (13 s). Same
    gaits, same mu levels, same nominal conditions, same 21 metrics -- the only
    change is hold 5s -> ramp hip_off 4s -> settle 6s -> blend 4s -> walk, instead
    of applying hip_off as a step at the start of the blend.
    Result: the slow start does NOT change the picture. Pass fraction moves by at
    most 0.05 for 1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
    [finalists_staged.csv]
2026-08-20 Select top-20 AT mu=0.7: the high-friction collapse was a selection artifact
    Every finalist so far was ranked at mu=0.1 and then re-run at the other mu
    levels, so "nothing survives at mu=0.5/0.7" only ever meant "gaits chosen for
    ice do not work on grippy floors". grid4_top_at_mu.py re-selects with the same
    rule as grid4_report (nbhd>=0.8 AND pass>0, sorted by net_fwd_mean) at any mu,
    and grid4_finalists_at.py runs the same 21-metric rich eval on that selection.
    Eligible cells at mu=0.7: c1 11,061 | c4 13,595 | c5 551 | c3 110 | c6 39.
    Pass fraction at mu=0.7 (survived AND net_fwd>0.05), top-20:
    config selected@mu0.1 selected@mu0.7
    c1 (k=0 COM1.05) 0.00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
    [finalists_mu07.csv, top_gaits_mu07.csv]
2026-08-20 ds_move_mu07: shuffle-vs-stepping at mu=0.7, selection-matched
    grid4_dsmove_fig.py draws the ds_move_frac violin at any mu using that mu's OWN
    selection (cN/finalists_mu<XX>.csv), so it is not "ice gaits on a grippy floor".
    --compare adds the other mu as a left panel on a shared y axis.
    cross/ds_move_mu07.png, medians (survivors only, n=20 each):
    config mu=0.1 sel mu=0.7 sel
    c1 (k=0 COM1.05) 0.762 0.198
    c3 (k=0 COM1.31) 0.604 0.173
    c4 (k=2 COM1.05) 0.288 0.048
    c5 (k=2 COM1.20) 0.233 0.048
    c6 (k=2 COM1.31) 0.113 0.017
    Two things the figure shows. Every config drops 3-6x when it walks on mu=0.7
    with gaits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
2026-08-20 gait_liveplot.py: render a gait with a live roll/yaw plot; c6 champion at mu=0.1
    Roll is measured about the robot's OWN heading, not a world axis, since the robot
    yaws ~70 deg in open loop and world-frame roll would mix the turn into the lean.
    Both reference axes are self-calibrated at the neutral stance instead of assumed.
    That matters: easytorso's body +y points straight DOWN ([0,0,-1] at t=0), so using
    it as a heading axis makes its horizontal projection vanish and both yaw and roll
    thrash through +-180. Heading now comes from the root body (leftthighmotor, +y is
    horizontal, the axis heading_align uses) and "up" from the torso's -y. Yaw is
    unwrapped because the robot accumulates turn; ro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
2026-08-20 com_wiper.py: COM sway vs height in the robot's OWN frame, plus animated video
    gait_sweep's com_lat measures lateral as com[0] - contact[0], i.e. WORLD x, with the
    comment "forward travel is +y". That assumption breaks once the robot yaws, and it
    yaws ~70 deg in open loop, so the existing com_lat/com_lat_rms mix sway with heading.
    Here the lateral axis is rebuilt every frame from the robot's own heading (root body
    forward axis projected horizontal, left = z x fwd), and sway is measured against the
    midpoint of the two feet. Plotting sway against COM height traces the
    inverted-pendulum arc.
    c6 champion at mu=0.1 (freq 1.96, hip_phi 240, leg 105, hip 28, off 20), walking
    window 11-24 s at 120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
2026-08-20 Session memo: GRID-4 analysis 2026-08-20 (machine D)
    Report for the 5 complete configs (c1, c3, c4, c5, c6); c2 still partial at
    264,949 rows and auto-skipped throughout.
    Leads with the three claims made earlier in the session that turned out to be
    wrong, so nobody works off the retracted version: finalist `valid` is a stepping
    gate not the pass criterion; the gaits DO self-start (all five, staged); and the
    mu=0.5/0.7 collapse was a selection artifact, not the robot -- re-selecting at
    mu=0.7 gives 0.85-1.00 pass for every config.
    Then: the three readings of the data checked against the map (kappa=2 dominant
    is NOT supported, it leads only at low mu; c6 fastest on ice confirmed; kappa=2
    mor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
2026-08-21 GRID-4 eval over all 6 configs: complete selection-matched diagonal
    c2 landed from rml3, so the gait x COM design is finally complete. Reran the
    whole package over 6 configs and added the selection at every mu, not just 0.1.
    New: grid4_diagonal_figs.py, and top_gaits_mu03/05/07.csv +
    finalists_mu03/05/07.csv for all six configs. Each mu now evaluates its own
    top-20, so every point is "the best this config can do on THAT surface" rather
    than "how an ice gait transfers".
    On the diagonal, pass fraction stops discriminating: all 24 config/mu cells sit
    at 0.85-1.00. The axis that separates the configs is speed of the passers:
    config k COM mu=0.1 mu=0.3 mu=0.5 mu=0.7
    c1 0 1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
    [finalists.csv, finalists_mu03.csv, finalists_mu05.csv, finalists_mu07.csv, top_gaits.csv, top_gaits_mu03.csv, top_gaits_mu05.csv, top_gaits_mu07.csv]
2026-08-21 Drop the superseded 5-config artifacts; repair REPORT.md and the map figures
    Two things, one of them a fix for my own mistake in ea9e601.
    FIX: ea9e601 committed a REPORT.md and four map-level figures that were still
    the OLD 5-config versions. When restoring demos I had deleted by mistake, I ran
    `git checkout HEAD -- results/grid4_report`, which also reverted every already-
    tracked file that the 6-config rerun had just regenerated. The "2 M" in that
    commit was the tell: REPORT.md showed as unmodified because it had been rolled
    back to its committed 5-config content. Regenerated: REPORT.md now lists all six
    configs, and volume/passfrac/speed/overlap plus both ds_move figures include c2.
    REMO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
    [finalists_staged.csv]
2026-08-21 RL ice arm: direct-joint-control env + PPO trainer + frozen eval (COM-1.31, mu U(0.1,0.4), vx_cmd 0.47)
    - grid4_rl_env: 36-dim obs (torque/slider/contacts added), 5-dim position
    targets @50Hz, no clock/phase, reward = task + declared stepping prior
    (swing/scrub), torso-neutral; DR tier-1 (obs noise, 20ms delay, init jitter)
    - train_grid4: gate0 (mu 0.7 qualification) / e2 (ice arm) modes, validated
    PPO hyperparams, diag.csv every 250k (components, per-dim sigma, torso RMS)
    - eval_grid4_policy: 24s frozen protocol, mu {0.1..0.4} +-5% x5, three-tier
    classification, effective-kappa readout
    - docs/rl_e2_ice_memo.md: experiment definition + frozen config + knob log
2026-08-21 rl_grid4: move RL stack to its own folder; add reset settle + topple-resample
    - rl/ (CPG legacy) untouched; new layout runs/<tag>/{ckpts,videos}
    - reset now holds stand targets until rocking decays (max|qvel|<0.3,
    0.3-1.0s) and resamples jitter draws that topple on their own
    (zero-action probe: 2/5 toppled -> 10/10 stand)
    - gate0_s0 (no settle) kept as baseline: lunge local optimum, tier 1
    no-walk at mu=0.7; knob log updated in rl_e2_ice_memo
2026-08-21 reward v2: progress weight 4->1, fall penalty 5->10; run tags carry reward version
    Frame-strip + component analysis of the v1 gate0 runs: the reward rise
    250k->500k came from r_progress/r_track while ep_len fell -- the dash
    harvests progress+track+swing from step 1 (~70/ep) while survival is
    priced at 0, so falling costs the optimizer nothing. v2 reprices so
    sustained terms dominate: stand(0) < dash(+4) < step-in-place(+100)
    < walk(+750); steepest ascent flips from 'dash faster' to 'live longer'.
2026-08-21 action mapping a1: cranks narrowed to -1.2 +- 0.6 rad, settle at working stance
    Full-range mapping (a0) made survival impossible under exploration noise
    (policy sigma ~0.9 x crank +-180deg = huge joint excursions; even standing
    dies <1s), so the dash stayed optimal regardless of reward pricing (r1, r2).
    Stance-angle scan over 8 jitter seeds: neutral -1.2 most topple-robust (7/8).
    Run tags now carry reward+action version (gate0_r2a1_s0).
2026-08-21 exploration e1: log_std_init 0 -> -1.0
    Noisy-stand probe: the robot is open-loop unstable under any uncorrelated
    action noise (0.7 s at sigma 0.85, 2.7 s even at sigma 0.15). At PPO's
    default init sigma~1 no rollout survives, so survival income is invisible
    and the dash is the only harvestable strategy regardless of reward pricing.
    Smaller init sigma puts multi-second survival into early rollouts.
2026-08-21 Gate 0 passed (w_s1 pass 3/5 at mu=0.7); freeze protocol, add ice-arm pipeline
    Frozen recipe per seed: stage A scratch at fixed cmd 0.47 (3M) -> stage B
    warm-start + curriculum c2 (3M). run_e2_arm.sh sequences 4 seeds under
    mu ~ U(0.1,0.4). Gate record and dead-end archive noted in the memo.
2026-08-21 mu-curriculum amendment: e2 stage A at fixed mu=0.4, stage B full U(0.1,0.4)
    Stage A from scratch under the full ice range dash-locked (1M steps,
    ep_len 16-18, fall 1.00): on low-mu episodes survival income is invisible
    and the dash resurfaces. Stage A now learns balance at the easy end of the
    arm's own range; --mu-fixed added to train_grid4.
2026-08-21 RL session memo 2026-08-21 + frozen-recipe finals, eval/diag CSVs, key demos
    Session memo (corrections-first): rl_design_memo c3/c6 ice numbers swapped
    (verified from topupK5); 7-round recipe iteration log; Gate 0 record;
    first two arm seeds' frozen evals (s0 passes mu 0.3/0.4 at 0.114/0.138,
    s1 passes nowhere, large seed variance; both below designed envelope).
    Artifacts: final.zip per key run (gate passer + arm stage A/B for s0/s1),
    diag/eval CSVs, two demos. Seeds 2-3 still training.
2026-08-21 eval/diag CSVs + gate-passer and arm-s0 demos (follow-up to b925c3a)
    [diag.csv, eval_frozen.csv, eval_gate0.csv]
2026-08-21 archive all training checkpoints (every 250k) + remaining diag/eval CSVs for all runs
    Full ckpt history for the dead-end rounds (nosettle, r2a0, r2a1, c1,
    c2-scratch), the gate runs, and arm seeds 0-2 (s2 stage B still training;
    its in-flight ckpt excluded).
    [diag.csv, eval_gate0.csv]
2026-08-21 rl_grid4: --cmd0 for curriculum resume, log vx_cmd, split torso roll DC from RMS
    Three diagnostics/plumbing fixes. None of them touches the reward, the action
    space, or any frozen quantity.
    1. --cmd0. Curriculum.__init__ set self.cmd = CMD0 (0.12) unconditionally, and
    --init-from restores policy+value weights only, so any --init-from
    --curriculum resume silently restarted the vx_cmd ramp from 0.12. There was
    no way to continue a run faithfully. --cmd0 sets the starting command.
    2. vx_cmd is now a diag.csv column. It is the only exogenous variable that
    changes during training and it was print-only, so the ramp history of an
    existing run cannot be recovered: gate0_r2a1e1c2_s0'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
2026-08-21 rl_grid4: stride symmetry + roll-rate diagnostics (Ben's design)
    Two additions, both diagnostics. No reward, action space or frozen quantity is
    touched.
    stride_L_m / stride_R_m / n_stride_L / n_stride_R / stride_asym. Touchdown-to-
    touchdown distance per foot, recorded on the contact rising edge that the
    substep loop already computes for scrub/swing. asym = (L-R)/(L+R); 0 means the
    two legs take equal strides, i.e. walking straight. Ben's point: this reads
    straightness off the LEGS, so unlike a yaw penalty it cannot leak into the
    torso variable. It is also strictly a measurement -- nothing optimises against
    it.
    torso_roll_rate_rms_dps = RMS of d(roll)/dt. Ben asked whether diff could
    repla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
2026-08-21 rl_grid4: --no-smooth ablation arm (action-rate weight 0), retagged
    Frozen r2 carries r_smooth = -0.01*||a_t - a_{t-1}||^2. --no-smooth sets that
    weight to 0 for an ablation arm. The weight is now a constructor argument
    (w_smooth, default W_SMOOTH_DEFAULT = 0.01) so the frozen path is bit-identical
    when the flag is absent.
    The run tag gains an 'ns' marker right after the reward version, so an ablation
    run is gate0_r2nsa1e1c2_s0 and can never be pooled with a frozen-recipe
    gate0_r2a1e1c2_s0 by accident.
    Verified: with the flag, episode r_smooth is exactly 0.0; without it, -0.0090
    on the same seed and action sequence.
    This is a reward change and therefore an ablation, not part of the frozen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
2026-08-21 rl_grid4: --rw generic reward-weight override, replaces one-flag-per-knob
    Every frozen r2 weight is now a key in RW_DEFAULT and overridable per run:
    --rw progress=3.0 single knob
    --rw swing=0.3 fall=5 combination
    Keys: track sigma2 progress back energy swing swing_cap scrub smooth fall.
    Unknown keys raise instead of being silently ignored. The tag records every
    override (gate0_r2-progress3a1e1c2_s0), so a tuning arm cannot be pooled with a
    frozen-recipe run. --no-smooth still works and is equivalent to --rw smooth=0.
    Verified the frozen path is unchanged: same seed and action sequence, default
    construction vs explicitly passing RW_DEFAULT gives max per-step reward
    di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
2026-08-21 rl_grid4: pre-declared reward-tuning queue (12 arms) + summariser
    tune_arms.txt lists 12 arms, each ONE single-factor change from the frozen r2
    baseline. They are declared before any of them runs, none is chosen in response
    to another's result, and none compounds on another -- so the sweep is not
    researcher-in-the-loop and the arms stay individually interpretable.
    progress 3.0 / 6.0 v1 used 4.0; v2's cut to 1.0 was aimed at the lunge,
    which settle + e1 actually fixed (probe-verified)
    swing 0.3 / 0.0 swing_rate is not gated on translation, so stepping in
    swing_cap 0.2 place harvests 25.6% of positive income
    fall 5.0 / 2.0 v2 double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
2026-08-21 rl_grid4: split reward ABLATIONS from magnitude tuning (Ben's correction)
    The first list mixed the two. progress=3.0 vs progress=6.0 picks between two
    arbitrary magnitudes; it answers "which number is better", not "is this term
    earning its place". Those are different questions and the second one has to be
    answered first.
    ablate_arms.txt (8 arms, now the queue default): each term switched OFF, one at
    a time, everything else frozen.
    no_track no_progress the two speed drivers; removing one leaves the
    other, so the policy always still has a reason
    to move -- this reads which one does the work
    no_swing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
2026-08-21 no-smooth ablation: 3 seeds from rml3
    [diag.csv]
2026-08-21 ice arm complete: 4-seed frozen evals, final table in session memo, per-seed demos, s2/s3 ckpts
    Final: s2 tier 3 (walk, torso active; all-mu pass; mu0.1 net_fwd 0.180 >
    kappa0 ceiling 0.164; mu0.3 0.344 > kappa2 0.242). s0/s1/s3 tier 1 under
    the strict all-mu rule (s0 walks mu 0.3/0.4, s3 walks mu 0.2-0.4). 0/4
    seeds in tier 2: every walking seed shows torso roll RMS >= 26 deg
    (eff_kappa 1.1-4.8).
    [diag.csv, eval_frozen.csv]
2026-08-21 runs/ layout cleanup: readable tree, self-identifying video names, --name flag
    e2/s{0-3}/{stageA,stageB}, gate0/s{0,1}/{stageA,stageB}, archive/<readable>
    for dead ends; old->new mapping in the session memo. Videos carry the run
    name. train_grid4 --name overrides the version tag (composes with the rml3
    no-smooth flag); run_e2_arm.sh updated. Thomas's gate0_r2nsa1e1c2_s* left
    untouched (his naming, different diag schema).
    [diag.csv, eval_frozen.csv, eval_gate0.csv]
2026-08-21 rl_grid4: triage_arms.sh -- which ablation arms deserve more seeds
    Ablation arms run at seed 0 only while the frozen baseline has 4 seeds, and the
    baseline's own seed spread is wide (0.063-0.224 at 3M). A single-seed arm that
    differs from the baseline by less than that spread is indistinguishable from
    seed noise, so believing it would be reading noise as signal.
    The rule, applied automatically: an arm is a candidate for extra seeds only if
    its median vx falls OUTSIDE the frozen seeds' own [min, max], or its hip_corr
    flips sign. The sign flip is in there because it separates an in-phase gait
    (both legs together, capped near vx 0.1) from an alternating one -- all seven
    from-scratch seeds so f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
2026-08-22 session memo: corrections from machine D cross-check
    - c2-scratch 'no path' was a premature 1.25M cut (machine D's full 3M run
    reached vx 0.224); warm-start stage may not have been necessary
    - clarify stage-B curriculum ramp-from-0.12 is designed behavior, distinct
    from the --init-from mid-curriculum resume bug machine D fixed
    - machine D's 6M convergence instability caveat applies to the 4-seed table
2026-08-22 ablation queue: 8 arms x 6M from rml3
    [diag.csv, eval_frozen.csv]
2026-08-22 reward audit: score the c6 designed gait under the frozen RL reward
    c6 (freq 1.77 hip_phi 270 leg_amp 105 hip_amp 28 hip_off 10, kappa=2 PID)
    replayed through Grid4RLEnv's reward accounting (full-range action bypass,
    declared: the frozen a1 crank band [-1.8,-0.6] cannot express its crank
    commands [0,+1.83] at all). At mu=0.1 c6 earns 0.58-0.75/step vs learned
    s2's -0.00..0.28; at mu=0.3 the ordering flips. Component detail in
    reward_audit_c6.txt.
2026-08-22 2x2 probe from the reward audit: crank band a2 (0.0+-1.9) x stepping priors off
    --crank-band on train/eval/render (a2 covers the c6 command domain that a1
    cannot express; settle stance follows band mid, 6/6 zero-action stand);
    priors-off cells use --rw swing=0 scrub=0 (audit: swing pays the shuffle
    more than real walking, scrub taxes intrinsic ice slip). run_e2x2.sh runs
    cells a2p1 / a1p0 / a2p0 through the full two-stage recipe + frozen eval;
    baseline a1p1 = existing e2/s0.
2026-08-22 ckpt sweep (rml2): best-vs-final for the four e2 arm seeds
    Task from docs/ckpt_sweep_rml2_memo.md. Every saved checkpoint of each arm
    seed's stage B (250k..3M + final, 13 each) through the frozen eval: 24 s,
    mu {0.1,0.2,0.3,0.4} +-5%, 3 repeats = 12 trials per checkpoint. Selection
    metric as fixed in the script (total pass count, tie-break mean net_fwd); not
    re-ranked by anything else.
    run best pass best pass final delta net_fwd best/final
    e2/s0/stageB 1500k 12/12 7/12 +5 0.3556 / 0.0730
    e2/s1/stageB 750k 11/12 1/12 +10 0.0925 / 0.0225
    e2/s2/stageB 3000k 12/12 10/12 +2 0.2378 / 0.2363
    e2/s3/sta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
    [ckpt_sweep.csv]
2026-08-22 best-ckpt confirmation evals (independent seeds): tier-3 2/4, s0@1.5M mu0.1 0.386
    Selection-rule amendment in the session memo: pick per-seed ckpt by eval
    (rml2 sweep), confirm on independent trial seeds (--trial-seed-base).
    s0@1.5M mu0.1 mean 0.386 (2.4x kappa0 ceiling; single trials to 0.574);
    s2@3.0M mu0.3 0.483 ~ kappa0's 0.490. eff_kappa spread 0.44-3.14 across
    seeds; tier 2 still empty.
    [eval_bestckpt_confirm.csv]
2026-08-22 Consolidate open RL concerns (C1-C8) + recover seed 0's overwritten diag
    docs/rl_open_concerns.md: everything unresolved in one place, ranked, each with
    the evidence pointer and what would settle it.
    C1 training does not converge -- between-seed spread (vtail 0.145/0.043/
    0.086/0.089) and one seed's own swing (0.095) are the same size, so every
    arm comparison is currently uninterpretable. 6M did not help.
    C2 final.zip is far from each run's best checkpoint: +2 to +10 pass, and s0's
    best is 4.9x its delivered net_fwd. Protocol question, not a script one.
    C3 nine from-scratch seeds across every arm learn an in-phase gait; no_swing
    does NOT flip it, so the step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
    [diag_from_log.csv]
2026-08-22 record C1-C8 resolutions; bc_express --clock/--frames; rml2 phase-2 task; fleet rules
    C2 adopted (best-ckpt + independent confirm as reporting protocol), C7
    adopted (warm-start dropped going forward; arm re-run queued), C6 resolved
    via go-forward single-stage protocol, C8 fleet rules into the fleet memo.
    bc_express gains the two C5 follow-up modes with an act_std column that
    catches mean regression immediately; score_designed_gait gains
    --skip-policy for the C4 bar measurement.
2026-08-22 2x2 rebuilt single-stage (C7 enforced): scratch + vx-curriculum, no stages
    The first 2x2 launch still used the two-stage warm-start structure after
    C7 was adopted — inconsistent; killed and archived (runs/e2x2_twostage_aborted).
    All four cells now run the go-forward protocol (from scratch, mu U(0.1,0.4),
    c2 curriculum, 3M), including a re-run a1p1 baseline cell, which also
    directly tests single-stage viability on ice.
2026-08-22 overnight search gen01: kernel is not the lever; FAKE-TORSO false positive caught by frames
    gen01 ran base / kernel_wide (sigma2 0.20) / kernel_off (track=0). Both kernel
    changes lost to the frozen baseline: ePass 0.75 -> 0.05 and 0.00.
    kernel_wide shows why widening does not work. r_track went 0.104 -> 0.360 and
    pos_sum 0.354 -> 0.597, a 68% richer budget, while performance collapsed: a wide
    kernel pays at any speed, so it removes the reason to go fast rather than adding
    gradient toward 0.47.
    kernel_off is the failure mode Ben warned about, and it was caught by looking at
    the frames rather than the table. Eval torso_roll_rms 41.3 with eff_kappa 4.22 --
    both of which read as strong torso u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
    [base.eval.csv, kernel_off.eval.csv, kernel_wide.eval.csv]
2026-08-22 REWARD r3: hf high-freq action penalty (w=0.5) after 5Hz cheat ruling; no-penalty e2x2 archived
    - e2x2 (r2, no penalty) complete: a1p1/a2p1/a1p0/a2p0 final evals in session
    memo section 5; a2p0 mu0.1 net_fwd 0.656 but ~5Hz aerial mincing morphology
    (42% airborne, slew past XM430 no-load 56-81% of steps) - ruled out
    - r_hf = -0.5*||a - act_filt||^2 (the content the alpha=0.2 filter rejects);
    calibration: c6 pays 7% of positive reward, a1p1-5Hz 54%, a2p0 16%
    - score_designed_gait: r_hf column (offline residual for the bypass replay);
    c6 rescored under r3: mu0.1 hf tax -0.038/step, TOTAL/step +0.54..+0.71
    - run_e2x2_hf.sh: full 2x2 rerun under r3, runs/e2x2hf/ (launched)
    - knob log + se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
    [diag.csv, eval_frozen.csv]
2026-08-22 Round 1 (r3) complete: 5Hz mincing gone, HELD-LEAN + mu-specialization remain; r3b band-fair hf launched
    - e2x2hf 4-cell finals + morphology probes in session memo (round-1 summary
    table); best cell a2p0 mu0.1 1.0/0.448 with torso-quiet 76% single support
    - r3b: hf residual x ctrl_half/a1-ref halves (a2 crank dilution ~10x fixed;
    a1 pricing unchanged; smoke: equal physical wiggle = equal tax both bands)
    - round 2 = a2p1/a2p0 re-run only, runs/e2x2hf2/ (launched)
    [diag.csv, eval_frozen.csv]
2026-08-22 r3b suicide diagnosed and killed; r3c: executed-signal HF penalty, hips+torso only, w=6.0; round-3 full 2x2 launched
    - r3b taxed exploration noise -0.94/step in a2 -> death (-10) beat living;
    killed at 250k, partial archived (runs/e2x2hf2/)
    - r3c prices act_filt cascade residual (what the servo executes), hips+torso
    only; per-dim audit: cheat HF is torso/hip-borne, c6 HF is crank-borne and
    crank speed limits await hardware facts (unpriced for now)
    - calibration at w=6.0: 5Hz-cheat 50% of pos reward, c6 9%, noise 0.085/step
    (suicide breakeven ~118 steps); smoke hip5Hz -0.044 crank5Hz 0.000
    [diag.csv]
2026-08-22 r3c stand-deadlock confirmed (2/2 cells 0/5 all mu) and archived; r3d launched: commanded-HF, hips+torso, w=1.0
    - r3c mechanism: executed pricing exempts noise, taxes coherent 1-3 Hz
    oscillation -> stand + sigma-walk wins; two cells confirm, pipeline stopped
    - executed-accel variant rejected offline (broadband noise accel > 5Hz cheat)
    - r3d returns to the round-1-validated commanded residual, restricted to
    hips+torso (cranks unpriced pending hardware), w=1.0 by stream calibration
    - round-4 full 2x2 at runs/e2x2hf4/
    [diag.csv, eval_frozen.csv]
2026-08-22 r3d w=1.0 dash-suicided at 500k (HT noise tax > standing income); round 4b at w=0.6 launched
    [diag.csv]
2026-08-22 overnight: torso follow is anti-correlated with speed; 18.5h incident recorded
    Two things.
    INCIDENT. I edited overnight/run_gen.sh at 01:06 while gen02, launched from that
    same file at 01:03, was still executing it. Bash reads scripts incrementally by
    byte offset, so rewriting a running script sends it to a wrong position; the
    parent shell died and its three training subshells took SIGHUP. Logs stop
    cleanly at "[curriculum] vx_cmd start 0.12" with no traceback and dmesg shows no
    OOM, which is the signature. The machine idled 01:06 -> 19:34. Generations now
    run from a frozen copy (run_gen_v2.sh, queue_v2.sh) never touched while live.
    FINDING. Across the four confirmed arm seeds, 79 survivin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
2026-08-23 RL: C2 retrofit of the ablation arms, and the term that was never measured
    The v2 harness's checkpoint-selection step never worked: eval_ckpt_sweep prints
    a label ("2000k") and the script fed it to [ -f ], so every generation fell back
    to final.zip. The sweeps themselves were valid, so fixup_c2.sh re-reads
    ckpt_sweep.csv and re-runs only the confirm and render; run_gen_v3.sh maps
    label -> path and warns instead of falling back silently. None of the 11
    selected checkpoints was final.
    Retrofit result: no_back is the fastest arm (eNfwd 0.321, ePass 0.90) and also
    carries the deepest torso lean (roll_mean -30.4 deg, negative in 17 of 18
    trials, deepening with mu). RMS 34.3 vs mean -30.4 puts a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
    [back0.eval.csv, back05.eval.csv, no_back.eval.csv, no_energy.eval.csv, no_fall.eval.csv, no_progress.eval.csv, no_scrub.eval.csv, no_smooth.eval.csv]
2026-08-23 RL: the overnight search trained at mu=0.7 and scored at mu=0.1-0.4; redo under e2
    Every generation ran --mode gate0 (mu fixed 0.7) while every eval ran at mu
    0.1-0.4. gate0 is documented in train_grid4.py as a qualification gate, not an
    experiment arm, and rl_e2_ice_memo.md records it as PASSED on 2026-08-21 with
    the protocol already moved to e2 (mu ~ U(0.1,0.4)). The gate0 line was copied
    from the memo's usage block into the rml3 one-liner and inherited by
    ablate_arms.txt, run_gen.sh, v2 and v3 without being re-examined.
    Discarded: the arm ranking, no_back at eNfwd 0.321, and corr(|lean|, net_fwd)
    = +0.650 -- all out-of-distribution readings. Survives: the reward-source
    finding that no te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
2026-08-23 Round 4b complete: a2 cells strongest eval lines of any round (a2p1 mu0.2 1.0/0.617; a2p0 broadest coverage, mu0.3 2.6Hz torso-quiet morphology); a1 cells stand; best-ckpt sweep launched
    [diag.csv, eval_frozen.csv]
2026-08-23 Reward audit: c6 under the frozen RL reward
    Ben asked, before any further move, whether c6 is a maximum of the current
    reward set at all.
    At mu=0.1 the reward ranks c6 at +0.615/step against -0.083, -0.353 and -0.367
    for the three C2-selected e2 checkpoints; nothing fell in any rollout, so the
    gap is not a survival artifact. Most of it is two terms: hf is -0.025 for c6
    against -0.24..-0.38 learned, and back is 0.000 for c6 against -0.17..-0.41.
    c6 is a local maximum along all five gait parameters -- 20 of 20 probes at
    +-10% and +-25% score lower (probe_c6_localmax.py, new).
    Two limits on that. The same c6 parameters earn +0.158/-0.091/-0.084 at mu=0.3,
    so they are a maximum at the mu they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
2026-08-23 a2p0@2000k confirmed on independent seeds: 16/20 across all four mu, tier 3 (first all-mu walker); mu0.3 morphology 2.00Hz / 74% single support / hips alternating
    [ckpt_sweep.csv, eval_bestckpt_confirm.csv]
2026-08-23 RL: straight-walk term, penalty shaping, and a suicide preflight
    Ben lifted the no-new-terms constraint for one term and asked for two things.
    straight: r_straight = -w * |stride_L - stride_R| / (stride_L + stride_R) on the
    last completed stride of each foot, 0 until both feet have taken one. Reads the
    legs only, so the torso stays unmeasured and "let torso use emerge" holds; the
    mechanism is that a torso parked to one side forces uneven compensation. It is
    already penalty-shaped and cannot be farmed by standing, since a standing robot
    scores no touchdown edge. Default 0.0.
    shape=penalty: shifts track/progress/swing so each tops out at 0 and the whole
    reward is <= 0, so standing bleeds ins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
2026-08-23 recipe kept: r3d+a2band+priors-off; seeds 1-7 queued behind the a2p0_ext torso-recruitment probe
2026-08-23 a2p0_ext probe: torso recruitment saturates ~4 deg by 3.5-4M; vx peaks 4M (0.553 det) then oscillates; 6M final worse than 3M; ext ckpt sweep launched; seed arm s1-s7 running
    [diag.csv]
2026-08-23 ext@5M confirmed 17/20: mu0.1 0.537 exceeds c6 ceiling 0.469, mu0.3 0.385; morphology still 3Hz/airborne 30-41% with mu0.3 lean episodes
    [ckpt_sweep.csv, eval_bestckpt_confirm.csv]
2026-08-23 r3d_arm complete: 8 seeds, 6/8 walk (finals 16,14,18,4,15,18,0,15 of 20); s7 mu0.2 0.661 speed record; two tier-3 seeds pass mu0.4 outright; per-seed ckpt sweep launched
    [diag.csv, eval_frozen.csv]
2026-08-23 r3d_arm definitive table: 4/8 seeds tier-3 confirmed 16-17/20; s4/s5/s7 confirmed mu0.1 exceed c6 ceiling (0.493/0.548/0.646 vs 0.469)
    [ckpt_sweep.csv, eval_bestckpt_confirm.csv]
2026-08-23 Arduino: pengu_champ standalone sketch — GRID-4 c6 champion gait (kappa=2 torso feedback, staged start, S_TILT sign-check helper)
2026-08-23 pengu_champ: wire in the webpage/wireless tabs (WiFi /cmd + /data), keep old param names for tab compatibility
2026-08-23 pengu_champ: extended-position mode (negative goals were silently rejected -> hip/torso no-move suspect), home printout, 1 Hz walk debug, 't' hand-rock stream
2026-08-23 Arduino: pengu_champ_k0 — c3 champion (Gait 1, kappa=0 world-upright torso), ice A/B counterpart to pengu_champ
2026-08-23 Arduino: pengu_champ_k0_105 — c1 champion (Gait 1 on the COM-1.05 build, counterweight lowered ~86 mm); c1 topupK5 data
    [topupK5.csv, topup_selection.csv]
2026-08-23 pengu_champ_k0_105: moderate 30-deg lean champion (K5-verified plateau) + IMU roll re-home at end of settle (drift compensation)
    [topupK5_off30.csv, topup_sel_off30.csv]
2026-08-23 pengu_champ_k0_105: hardware roll home hardcoded at -2 deg (settle EMA kept as diagnostic); torso PID clamp tightened to +-10 deg (torso was hitting the legs)
    [pengu_champ_k0_105.ino]
2026-08-24 EXECUTION sv1: servo slew clamp @4.82 rad/s (XM430-W350 @12V, Profile Velocity model)
    - env clamps applied target slew; --no-slew = legacy sv0 (bit-repro verified)
    - designed c6 under sv1: mu0.1 -6% (0.374), mu0.3 collapses (-0.008, 2/3 falls)
    - confirmed RL champions nearly clamp-invariant (s7@2750k 17/20, mu0.1 0.597)
    - run tags append sv1; sv0/sv1 pools must not be mixed (fleet memo announced)
    - clamp-native retrain probe launched (kept recipe seed 0)
    [eval_sv1_zeroshot.csv]
2026-08-24 sv1-native probe: 16/20 tier-3 at final without selection; mu0.1 0.401 at 2.60Hz (sv0 counterpart: 0.307 at 3.25Hz) - honest actuation trains faster AND lower-frequency
    [diag.csv, eval_frozen.csv]
2026-08-24 REWARD r3e: dutybal single-support balance penalty (heavy-lean killer, deadzone 0.25); eval tier-3 split into 3-lean/3-sway; fix --no-slew branch capturing the penalty-shape preflight
    - straight proxy failed calibration (no separation on ice) and stays 0
    - dutybal calibration: heavy lean -0.054/step (32% of income), mild lean and
    clean walkers <=0.007, standers 0 (no suicide gradient)
    - r3e probe launched (kept recipe + sv1 + dutybal, seed 0)
2026-08-24 r3e probe archived: dutybal prunes heavy lean while keeping sway; best contact structure yet (airborne 15-16%, double support 16-17%, mu0.4 at 2.20Hz); tier print now splits 3-lean/3-sway; P1 energy 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
    [ckpt_sweep.csv, diag.csv, eval_frozen.csv]
2026-08-24 P1 energy x20 A/B: speed jumps (mu0.2 0.547, mu0.3 0.367 at 2.20Hz torso-quiet = 151% of c6 mu0.3 ceiling) with frequency held; mu0.4 regresses; mild lean returns at low mu
    [diag.csv, eval_frozen.csv]
2026-08-24 r3f: energy removed (Ben); eff-kappa direction measured on quiet-torso walkers: positive 0.2-1.2, passive torso joint - kappa2-side discounted follow, never kappa0
2026-08-24 RL findings digest for machine D: sv1 impact, r3d->r3f reward line, tier-3 lean/sway split, confirmed arm headlines, kappa direction of the emergent sway
2026-08-24 P4 probe: sv2 command bandwidth cap (2nd-order LPF 2.5Hz, firmware-replicable), curriculum cap 0.70, mu=0.1-only training; launched
2026-08-24 P4 probe complete: crossing the speed frontier doubles torso command activity (still small, 1.8deg RMS, eff-k 1.2); strongest training tail on record; --cmd-fc plumbed into eval tools (execution-laye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
    [diag.csv, eval_frozen.csv]
2026-08-24 P4 wrap: 3/3 seeds confirmed 5/5 at mu0.1; s0_ext@3.5M 0.638 ties the record under the 2.5Hz cap; sustained 0.70 demand recruits torso slowly (to ~3deg joint RMS, kappa 0.5-0.9); all walkers are tier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
    [ckpt_sweep.csv, diag.csv, eval_bestckpt_confirm.csv, eval_frozen.csv]
2026-08-25 All champ sketches: READY returns every motor to Dynamixel ABSOLUTE ZERO (neutral = servo 0 convention); boot pose held to avoid power-on snap; home re-latched in extended coords after zeroing
    [pengu.ino, pengu_champ.ino, pengu_champ_k0.ino, pengu_champ_k0_105.ino, webpage.ino, wireless.ino]
2026-08-25 Champ sketches: fix undeclared latchHome (computed extended-zero home instead), hip rest lean 10 deg fwd, walk offset ramps from rest, 'p' motor health report
    [pengu_champ.ino, pengu_champ_k0.ino, pengu_champ_k0_105.ino]
2026-08-26 Project status report 2026-08-25: six-config table complete, c4 full-passer topupK5 shipped (391,285 rows), six-config map rerun, hardware day-1 mocap readout
    [fig45_metrics.csv, fig45_metrics_prev.csv, topupK5.csv, topupK5_f14.csv, topup_sel_f14.csv, topup_sel_f14_off30.csv, topup_selection.csv]
2026-08-26 Wrap-up: non-RL lessons from 2026-08-14 to 08-25
    Everything except the RL findings: the Onshape -> URDF -> MuJoCo pipeline and
    where its credentials live, the shared-account setup, the GRID-4 analysis
    lessons, and each process failure with the fix it forced.
    The four analysis lessons that actually changed a conclusion: a cross-condition
    comparison built on a single-condition selection measures the selection (the
    "high-friction collapse" was the mu=0.1 top-20 re-scored elsewhere; the diagonal
    moved pass 0.00 -> 0.85-1.00); a column named `valid` is not the map's `pass`;
    a scalar hid walking in circles (5.74 m of path, 0.61 m net, straightness
    0.107); and RMS cannot separate a waddle from a h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
    [r3f_s0.eval.csv, r3f_s1.eval.csv, r3f_s2.eval.csv]
2026-08-26 GRID-5: round-2 sweep pipeline (grid5/), COM 1.10/1.40 models, frozen protocol + fleet launch docs
    - models/pengu1_10, pengu1_40: derived from pengu1_31 (easytorso inertial COM slid
    -67.82/+41.53 mm along the counterweight axis; total mass 2.2724 kg unchanged;
    meshes byte-identical; verified vs the load-time slide to <1e-10 m)
    - grid5/: self-contained duplicate of the GRID-4 pipeline (427b701 backup untouched):
    staged start (quiescence hold, 5 deg rest lean, ramped hip_off), +19 extended
    metrics (dual-criterion slip, cone/GRF, lateral, COT, torso-IMU, fall timing),
    10-config driver c1-c10 with per-CSV manifest (refuse on mismatch), topup,
    launcher/watchdog/per-machine queue runne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
    [bracketbearingside.stl, bracketmotorside.stl, crank_circle.stl, crank_link.stl, easymotor.stl, easymotorwithconnector.stl, left_thigh.stl, part_1.stl]
2026-08-26 GRID-5 fleet: rml2 runs full CPU (sweeping first; RL track paused)
2026-08-26 GRID-5: plotting brief for a separate plot-only analysis session
    Column dictionary for all 31 map columns, frozen tier/neighborhood definitions,
    loader+cache contract, 15-figure catalog, and the traps that produced wrong
    conclusions in round 1 (single-mu selection, valid-vs-pass, averaging ext metrics
    over fallen trials, RMS lean/waddle degeneracy).
    Two issues found while writing it:
    - the hip_phi dead-band cut makes np.roll neighborhoods join phi=140 to phi=200;
    round-1 neighborhood code copied unchanged has this bug
    - the design's T-slip track and clean-pass tier key on slip_ratio2, which is not
    a column and cannot be derived from the map (path is not carried); flagged as
    an open it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
2026-08-26 GRID-5 v2: PURE deterministic map — exact nominal mu, no pose jitter, no RNG, K=1
    Ben 2026-08-26: 'everything fixed, no random stuff at sweep — don't contaminate
    the sweep'. DR/robustness moves entirely to the post-map champion stage (designed
    after the map completes); topup_k.py v1 jittered merge guarded out (refuses under
    grid5-v2). Manifest protocol bumped to grid5-v2 (old v1 partial CSVs are refused).
    Verified: two full smoke runs bit-identical.
2026-08-26 GRID-5 v2.1: restore full hip_phi circle (36 pts) — the {150..190} trim's evidence was start-protocol-contaminated GRID-4 data; freq trim kept (champion physics). 2,488,320 rows/config; completed v2 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
2026-08-26 GRID-5 docs: leg extension vs crank-amp figure (0/85/135/165 deg; slider rail 50 mm, 85=33% 135=79% 165=97% of stroke)
2026-08-26 GRID-5 docs: hip swing vs amp figure (0/12/20/32 deg; ~1.7 mm fore-aft per deg at the foot)
2026-08-26 GRID-5 v2.3: drop leg 65 and hip 8 (save ~22% map time) -> leg 75-165, hip 12-32, 4,147,200 rows/config
2026-08-27 GRF presentation: cone_util map figure (cone_util_p95 vs mu, IQR band) + grf_cone mechanism scatter (per-sample Fn/Ft vs friction cone, multi-mu panels)
2026-08-31 GRID-5 c6 map COMPLETE (kappa=2 COM 1.31, v2.3 deterministic): 4,147,200 rows
    Integrity battery: row count exact; 4,147,200 unique 6-tuples; 0 malformed;
    all axis marginals exact (80/36/10/6/6/4); 0 consistency violations (pass gate,
    fall_phase/t_fall pairing, K=1 min==mean, t_start range); 12-row replay
    bit-identical across all 25 metric columns.
    Two benign surv=0 populations documented: 89 rows cot=0 (toppled within ~50 ms
    of the measure window), 80,808 rows imu_roll_rms>120 deg (pre-fall samples);
    zero passers affected.
    Headline pass>0 volume by mu: 14.8 / 5.7 / 2.5 / 2.4 % (0.1/0.3/0.5/0.7).
    Shipped as 90 MiB gz parts (gz 174 MB exceeds GitHub's 100 MB cap); reassemble:
    cat <csv>.gz.part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
2026-08-31 GRID-5 v2.4 fix: mu=0.9 is a c6-only probe, not a global axis; other configs stay on 4 mu points
2026-08-31 GRID-5: demo output convention (sweep demos -> results/grid5_report/<cfg>/demos/, dual camera); c6 demos: fastest-gait mu0.1 clip, GRID-4-champion dual-cam clip + torso-roll trace (kappa tracking slo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
2026-09-01 GRID-5 c6 map COMPLETE at FIVE mu (v2.4: +0.9 high-grip probe): 5,184,000 rows
    Integrity battery PASS: exact row count, 5,184,000 unique 6-tuples, 0 malformed,
    all axis marginals exact (80/36/10/6/6/5-mu), 0 consistency violations.
    pass>0 by mu: 14.8 / 5.7 / 2.5 / 2.4 / 2.6 % (0.1/0.3/0.5/0.7/0.9)
    surv>0 by mu: 46.5 / 44.7 / 33.6 / 31.9 / 32.3 %
    mu=0.9 sits on the mu=0.7 plateau (no high-grip upturn). Replaces the 4-mu parts.
2026-09-01 GRID-5 c5 map COMPLETE (kappa=2 COM 1.20, v2.3 deterministic): 4,147,200 rows
    Integrity battery PASS: exact count after removing 1 torn line (reboot-window
    write scar, clean twin re-written by resume) and separating 464,728 mu=0.9 rows;
    0 duplicates; all axis marginals exact; 0 consistency violations.
    pass>0 by mu: 20.8 / 14.7 / 4.8 / 3.8 % surv>0: 55.4 / 73.9 / 51.5 / 46.6 %
    (surv peaks at mu0.3, above mu0.1.)
    Side artifact sweep_grid5_c5_mu09_bonus.csv.gz: 464,728 valid deterministic
    c5@mu0.9 rows written 08-30 22:22 -> 08-31 10:30 by a pull that landed in the
    15-minute window between the global-mu0.9 push and its c6-only fix — kept as a
    free 45% slice of c5@0.9, NOT part of the 4-mu m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
2026-09-01 GRID-5 c3 map COMPLETE (kappa=0 COM 1.31, v2.3 deterministic): 4,147,200 rows
    Shipped as 90 MiB gz parts; reassemble:
    cat <csv>.gz.part* > <csv>.gz && gunzip -k <csv>.gz
    Passing cells by mu: 87,459 (0.1) / 86,080 (0.3) / 33,617 (0.5) / 15,316 (0.7).
    Unconstrained best net_fwd sits at freq 1.94-1.99 with leg_amp 145-165 on every mu.
    Hardware bound measured 2026-08-30: the crank servo's peak velocity saturates at
    354 +- 4 deg/s (12 measurements, air and ground pooled, commanded 424-613 deg/s).
    Peak crank rate is pi*f*A_leg, so only 2-11% of the passing cells per mu are
    executable and the unconstrained optima are 2.5-2.9x over it. Best executable per mu:
    mu 0.1 1.21 / 280 / 85 / 20 / 20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
2026-09-01 Hardware campaign 2026-08-28..31: firmware, analysis pipeline, and the actuator envelope
    Firmware (Arduino/). Every sketch flashed during the campaign, so each hardware record
    has its provenance. The line ends at pengu_tune_wifi:
    pengu_tune_wifi/ WiFi only -- the USB socket broke when the robot fell and pulled the
    cable. No serial interface at all: buttons at 192.168.4.1, and the run
    is captured into a 570-record RAM ring (21 B/sample) and downloaded
    afterwards via GET /dump. Nothing is transmitted while walking; a radio
    write inside the control loop would perturb the period being measured.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
    [hip_probe.ino, imu_probe.ino, motor_probe.ino, pengu_champ_k0_test.ino]
2026-09-01 GRID-4 c6 topupK5 (all passers)
    42,593 rows -- every K=1 passing row of the c6 map re-scored with the full 5
    seeded repeats. Covers the selection exactly: no missing keys, no extra keys.
    Run on machine C (XPS/WSL2) with a pre-filtered base map. topup_k.py reads the
    base only via base[key] for keys in the selection, so passing a base containing
    just those rows is numerically identical -- and it cuts per-shard RSS from
    2839 MB to 488 MB. With the full 1.8M-row map, 10+ shards exhausted the VM and
    the OOM killer took PID 1, which makes WSL terminate the whole distribution.
    The raw output held 9,445 duplicate rows from overlapping relaunches during that
    crash loop. All 9,445 were byte-identica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
2026-09-01 models/pengu1_05cad: real CAD export of the lowered-counterweight build + analysis memo
    Measured (hips-0 neutral): COM ratio 1.0440 (target 1.05), total mass 2.1724 kg
    — 100.0 g LIGHTER than the mass-conserving sweep model (2.2724), all in easytorso.
    vs the against-physics slide tune (1.31 base, ipos -86.05 mm, inertia kept):
    easytorso principal inertia is 1.70x / 1.40x / 5.9x larger in the CAD-true model;
    whole-robot COM fore-aft differs 3.6 mm. Raw export (9 actuators), analysis only.
    [100g.stl, 10g.stl, 10g_holder__short.stl, battery.stl, bracketbearingside.stl, bracketmotorside.stl, crank_circle.stl, crank_link.stl]
2026-09-02 GRID-5 c1 slice: hip_phi 0 and 10 complete across all six hip_off blocks
    230,400 rows, produced on machine C (laptop) under grid5-v2, K=1, 19 shards.
    Verified: 230,400 unique 6-axis tuples, no duplicate lines, all 31 columns, and
    every one of the twelve (hip_phi, hip_off) cells holds exactly 19,200 rows.
    Header identical to the working CSV; manifest is the config manifest and matched
    throughout (protocol grid5-v2, config c1, K=1).
    Produced with a cells()-only filter wrapper, so these rows are bit-identical to
    the same rows from a full sweep -- the axis definitions, seeds, physics and
    manifest are untouched. See docs/grid5/machineC_laptop_memo.md.
    Overlaps the earlier hip_off 0/10 artifact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
